hiroyams/openarm_hardware/README.md

# OpenArm Hardware



### CAD Files
All CAD files needed to build, print, and customize the OpenArm hardware platform:   
**[📁 Google Drive](https://drive.google.com/drive/folders/1a9ec9vzBV_D-AX9s_LOkBVy3ZXDC1kJT?usp=sharing)**
- **STEP** — Full assembly (leader & follower arm)
- **STL** — Ready-to-print 3D models
- **Attachments** — Camera mounts, PCB hub casing, etc.
- **Wiring** — Diagrams for cable manufacturing

### Documentation
Specifications, bill of materials (BOM), and step-by-step assembly guides:  
**[📚 docs.openarm.dev/hardware](https://docs.openarm.dev/hardware/)**  

## Contributing
We welcome contributions! Submit a pull request with:
- Custom modifications and improvements
- Assembly files for other CAD platforms (SolidWorks, OnShape, FreeCAD, etc.)
- Documentation enhancements

**Discord** — [Join our community](https://discord.gg/tpnKxHuJY3) for questions and project sharing  
**Email** — openarm@enactic.ai

## License
[CERN Open Hardware Licence Version 2 - Strongly Reciprocal](LICENSE.txt)  
Copyright 2025 Enactic, Inc.

All participation is governed by our [Code of Conduct](CODE_OF_CONDUCT.md).
