hiroyams/openarm_hardware/SolidWorks/covers/J4-J5_Cover.SLDPRT

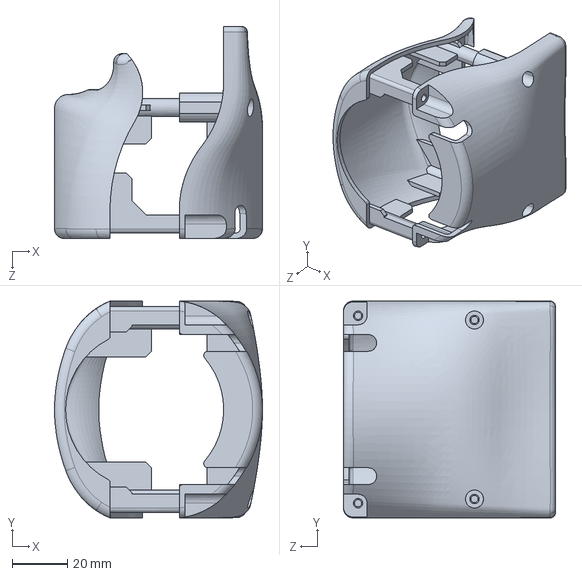
[picture p1: CAD file, 2025-08-22, last stored version]
SolidWorks/covers/J4-J5_Cover.SLDPRT
75.0 x 78.2 x 76.5 mm
