hiroyams/openarm_hardware/SolidWorks/motors/DM-J4340-2EC.SLDPRT

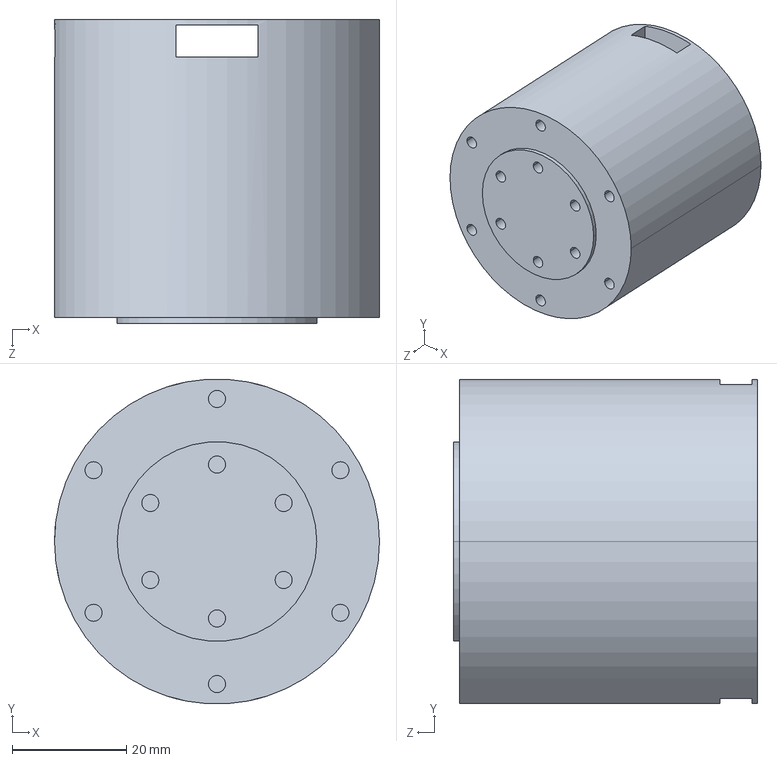
[picture p2: CAD file, 2025-08-22, last stored version]
SolidWorks/motors/DM-J4340-2EC.SLDPRT
57.0 x 56.9 x 53.3 mm
