hiroyams/openarm_hardware/SolidWorks/pedestal/pedestal_v1.0_final.STEP

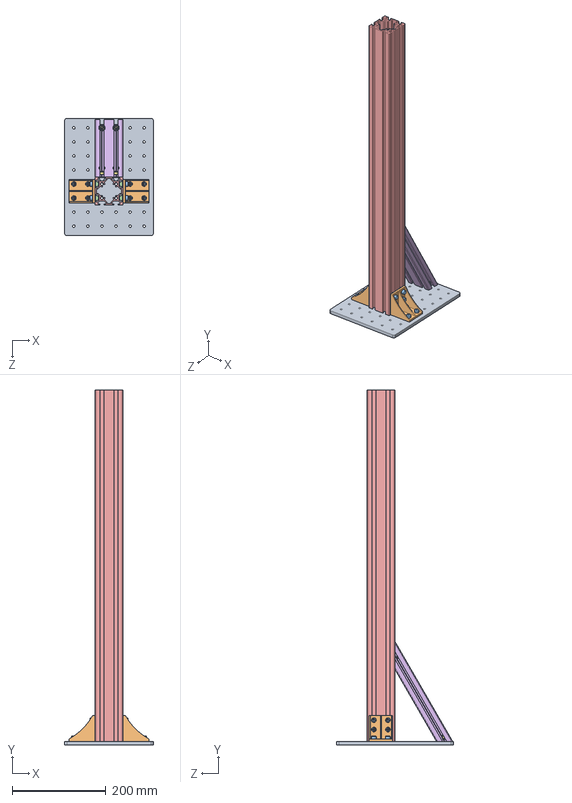
[picture p3: CAD file, 2025-08-22, last stored version]
SolidWorks/pedestal/pedestal_v1.0_final.STEP
190.0 x 758.0 x 250.0 mm
base_plate
HBLFSDW6-SEP_b x 2
CBM6-12 x 16
HNTP6-6_app x 8
Reazon_HFSB6_6060_750
HFBL30A6-3060-123-SSP_b
SCB6-12 x 4
SPWF6 x 4
SHNTP6-6 x 2
