hiroyams/openarm_hardware/SolidWorks/SLDPRT_Files/wrist_camera_mount_right.SLDPRT

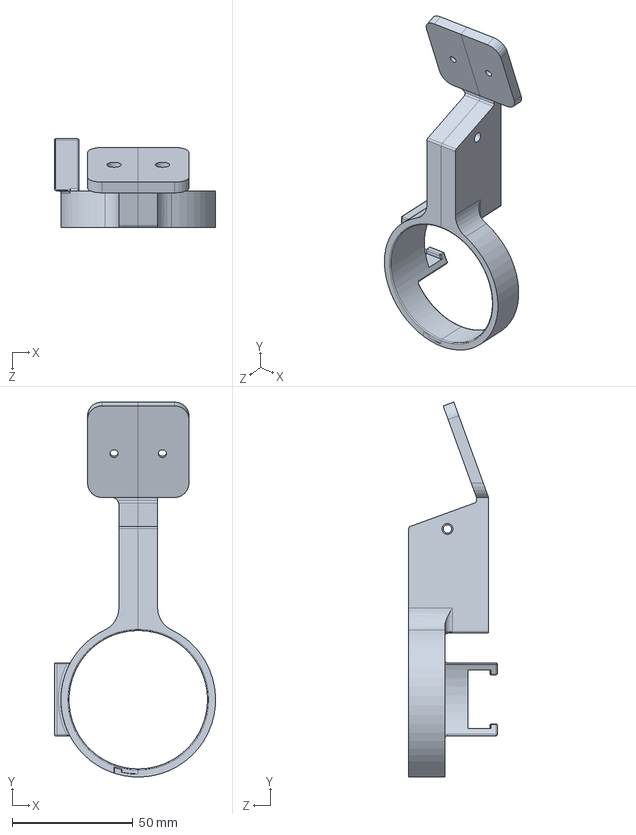
[picture p4: CAD file, 2025-09-16, last stored version]
SolidWorks/SLDPRT_Files/wrist_camera_mount_right.SLDPRT
66.6 x 155.0 x 36.6 mm
