hiroyams/openarm_hardware/SolidWorks/STEP_Files/J2_B.STEP

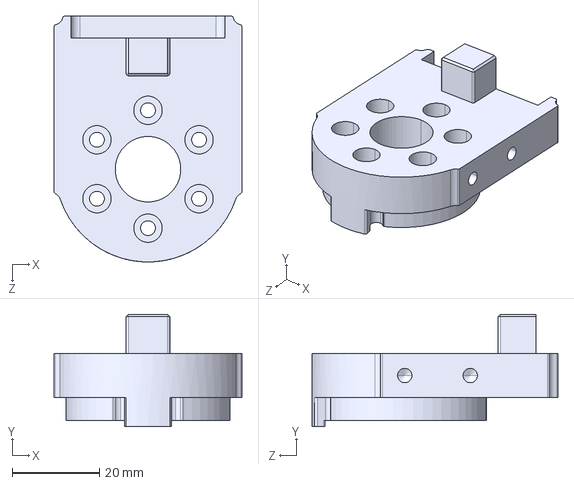
[picture p5: CAD file, 2025-08-22, last stored version]
SolidWorks/STEP_Files/J2_B.STEP
43.0 x 25.7 x 56.3 mm
