hiroyams/openarm_hardware/STL/covers/chest-b.STL

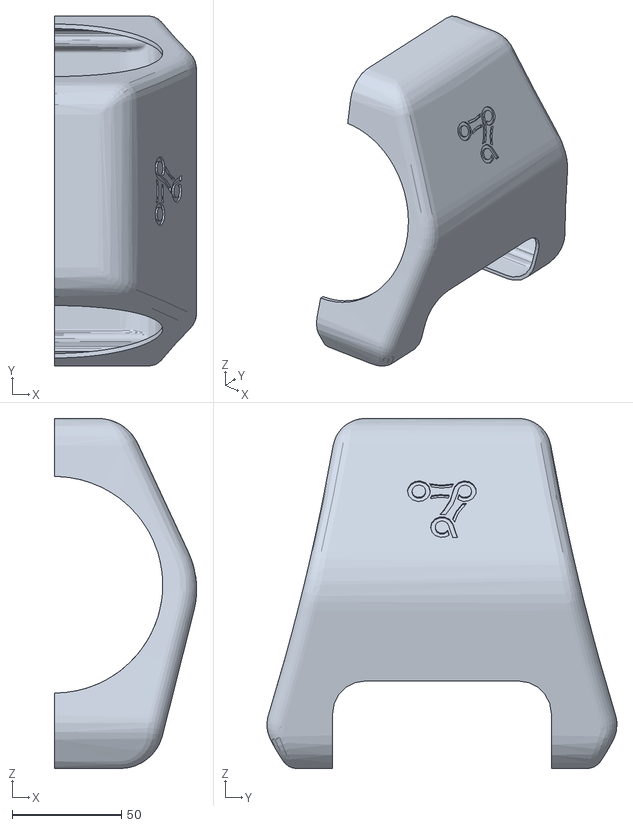
[picture p7: CAD file, 2025-07-17, last stored version]
STL/covers/chest-b.STL
65.0 x 160.0 x 160.0
