hiroyams/openarm_hardware/STL/covers/left/left_covers.3mf

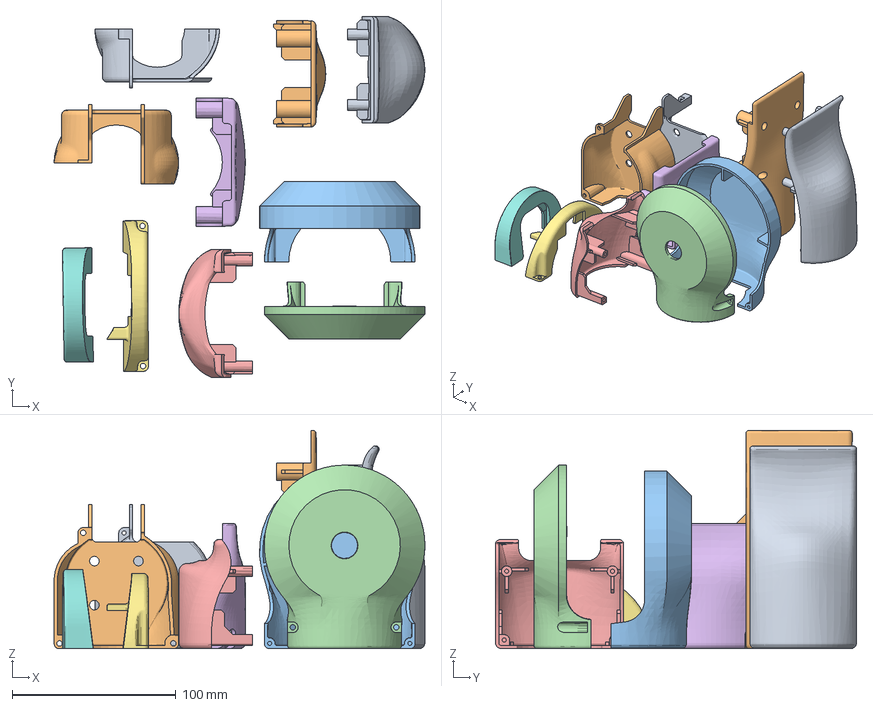
[picture p8: CAD file, 2025-08-27, last stored version]
STL/covers/left/left_covers.3mf
226.2 x 220.2 x 133.2 mm
j3-a-right.STL
j3-b-right.stl
j1-b-right.STL
j2-b-right.STL
j4-a-right.STL
j4-b-right.STL
j1-a-right.STL
j2-a-right.STL
j6-a-left.STL
j6-b-left.STL
