hiroyams/openarm_hardware/STL/follower/left-jaw.STL

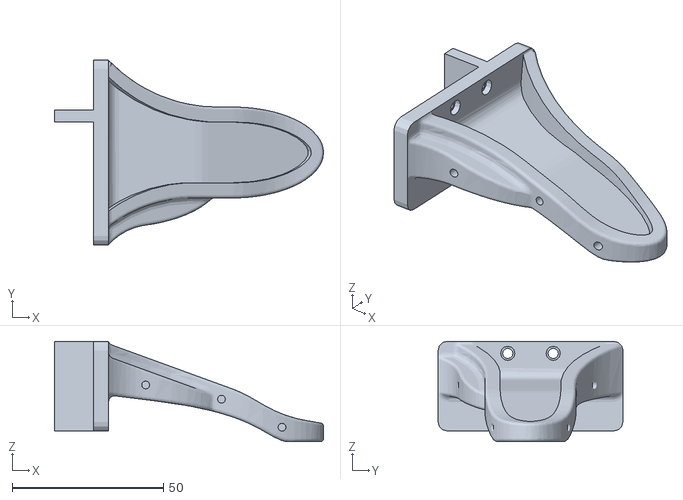
[picture p9: CAD file, 2025-07-17, last stored version]
STL/follower/left-jaw.STL
88.8 x 61.0 x 33.2
