hiroyams/openarm_hardware/STL/leader/swivel-rotor-leader.STL

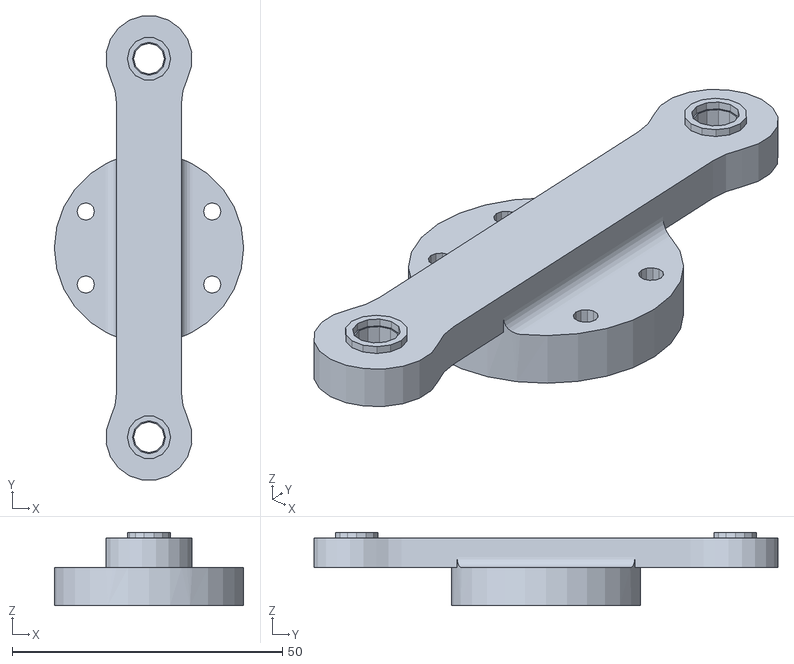
[picture p10: CAD file, 2025-07-17, last stored version]
STL/leader/swivel-rotor-leader.STL
35.0 x 85.8 x 13.5
