hiroyams/openarm_hardware/SolidWorks/covers/J1-J2_Cover.SLDPRT

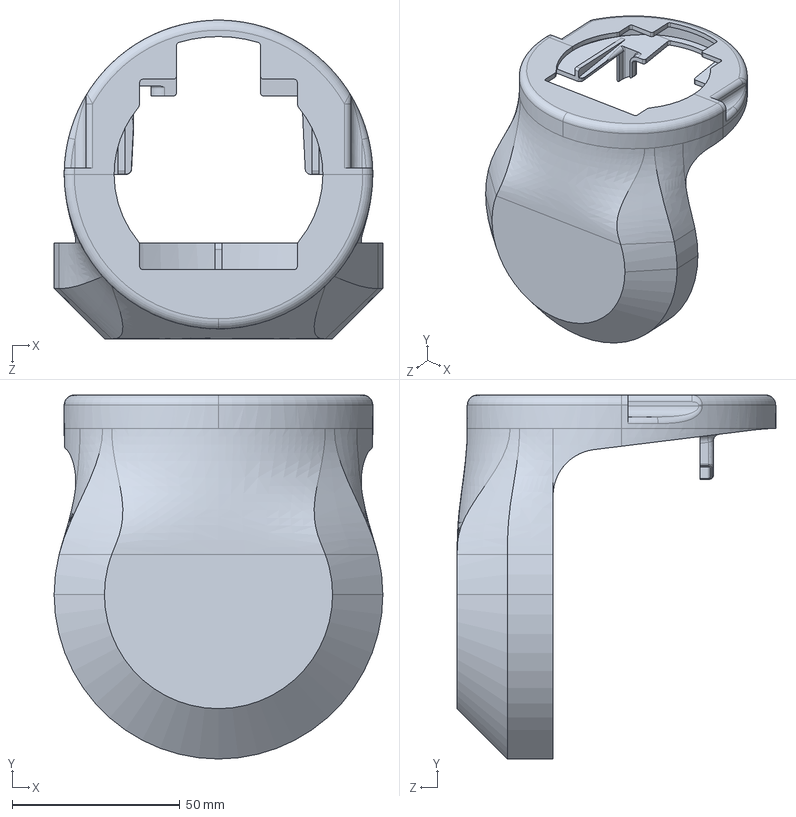
[picture p11: CAD file, 2025-08-22, last stored version]
SolidWorks/covers/J1-J2_Cover.SLDPRT
98.0 x 108.5 x 95.0 mm
