hiroyams/openarm_hardware/SolidWorks/motors/DM-J8009P-2EC.SLDPRT

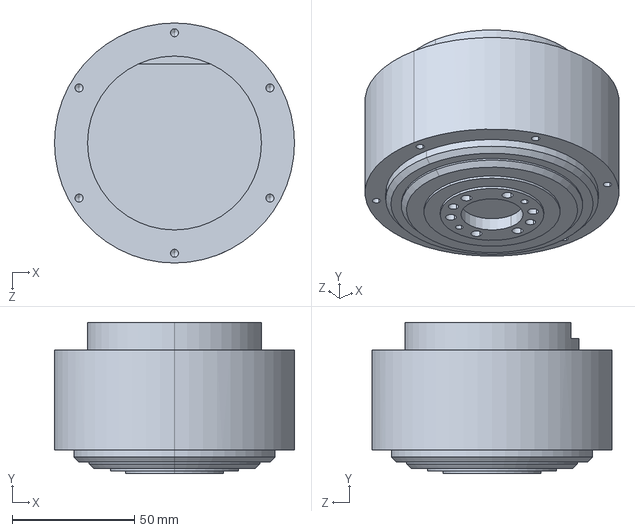
[picture p12: CAD file, 2025-08-22, last stored version]
SolidWorks/motors/DM-J8009P-2EC.SLDPRT
98.0 x 61.7 x 98.0 mm
