hiroyams/openarm_hardware/SolidWorks/STEP_Files/J7_D_right.STEP

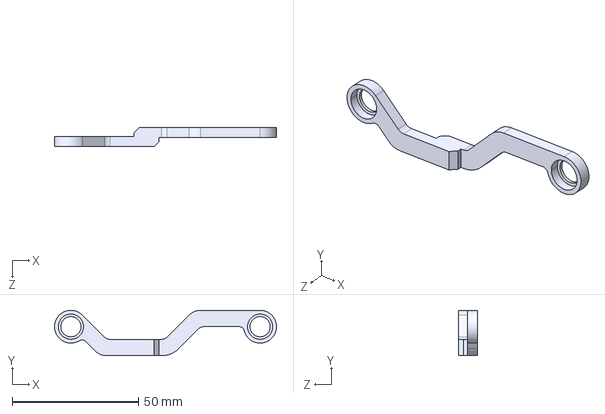
[picture p13: CAD file, 2025-08-22, last stored version]
SolidWorks/STEP_Files/J7_D_right.STEP
88.0 x 18.0 x 7.50 mm
