hiroyams/openarm_hardware/STL/covers/chest-a.STL

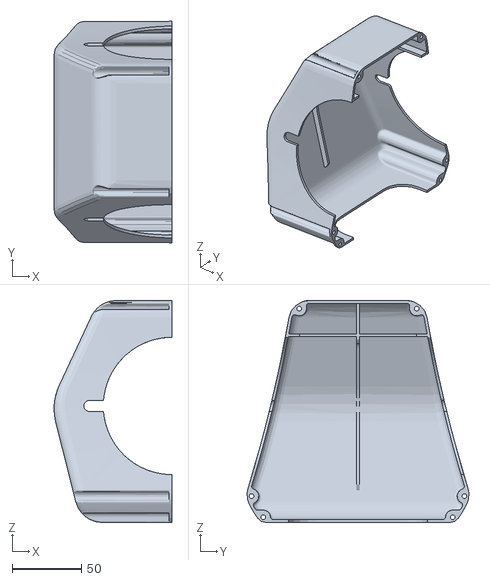
[picture p14: CAD file, 2025-07-17, last stored version]
STL/covers/chest-a.STL
85.0 x 160.0 x 160.0
