hiroyams/openarm_hardware/STL/covers/left/j6-b-left.STL

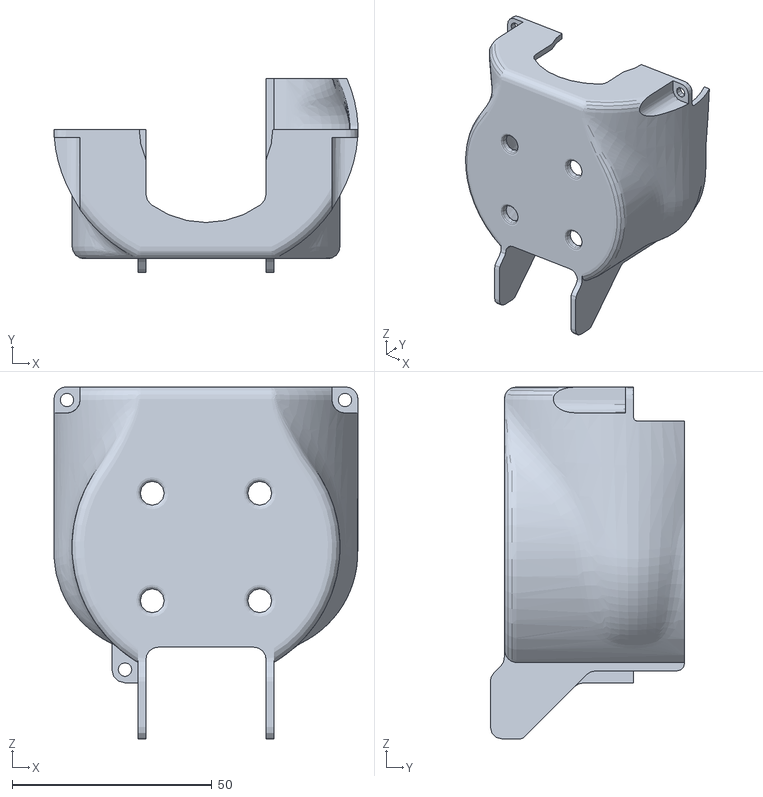
[picture p15: CAD file, 2025-07-22, last stored version]
STL/covers/left/j6-b-left.STL
76.0 x 48.6 x 88.0
