hiroyams/openarm_hardware/STL/covers/right/j2-b-right.STL

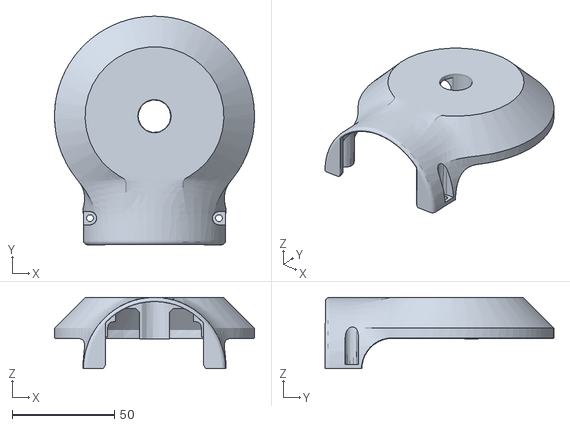
[picture p16: CAD file, 2025-07-22, last stored version]
STL/covers/right/j2-b-right.STL
98.0 x 112.0 x 34.8
