hiroyams/openarm_hardware/STL/leader/ee-linkage.STL

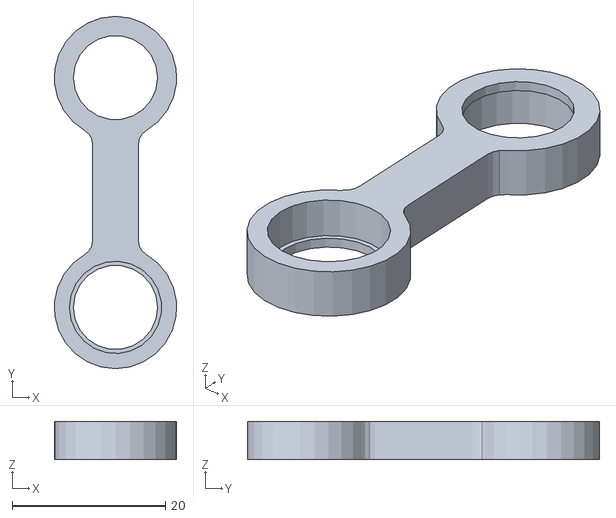
[picture p17: CAD file, 2025-07-17, last stored version]
STL/leader/ee-linkage.STL
15.9 x 46.0 x 5.00
