hiroyams/openarm_hardware/SolidWorks/covers/J6-J7_Cover_Left.SLDPRT

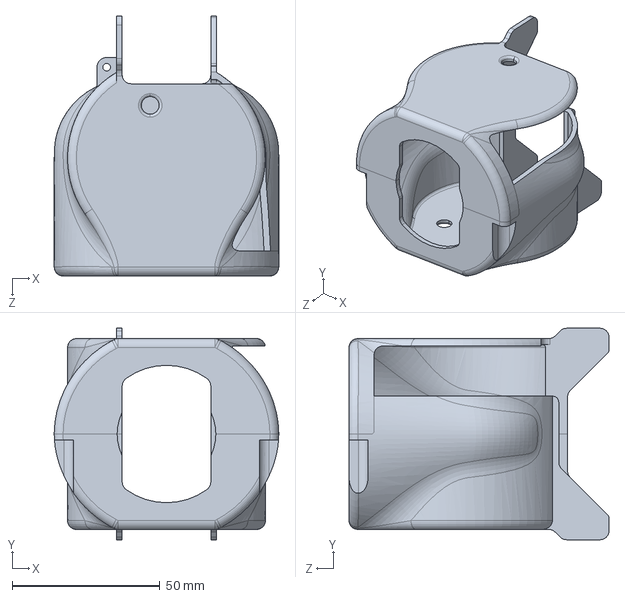
[picture p18: CAD file, 2025-08-22, last stored version]
SolidWorks/covers/J6-J7_Cover_Left.SLDPRT
76.0 x 71.6 x 88.0 mm
