hiroyams/openarm_hardware/SolidWorks/motors/DM-J4310-2EC.SLDPRT

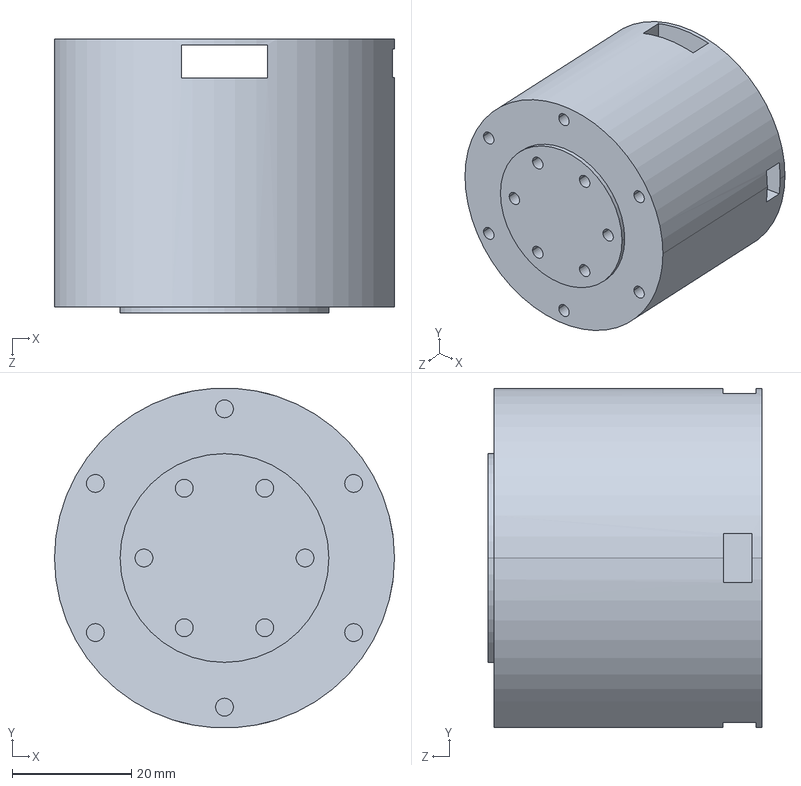
[picture p19: CAD file, 2025-08-22, last stored version]
SolidWorks/motors/DM-J4310-2EC.SLDPRT
57.0 x 56.9 x 46.0 mm
