hiroyams/openarm_hardware/SolidWorks/STEP_Files/J7_E.STEP

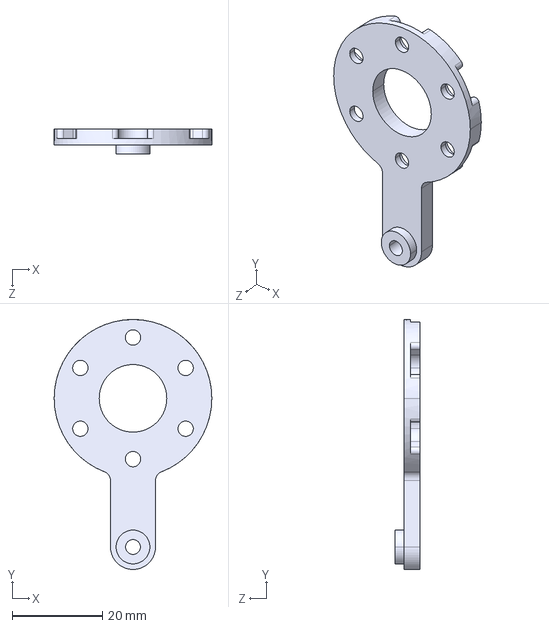
[picture p20: CAD file, 2025-08-22, last stored version]
SolidWorks/STEP_Files/J7_E.STEP
35.0 x 55.5 x 5.60 mm
