hiroyams/openarm_hardware/STL/covers/right/j6-a-right.STL

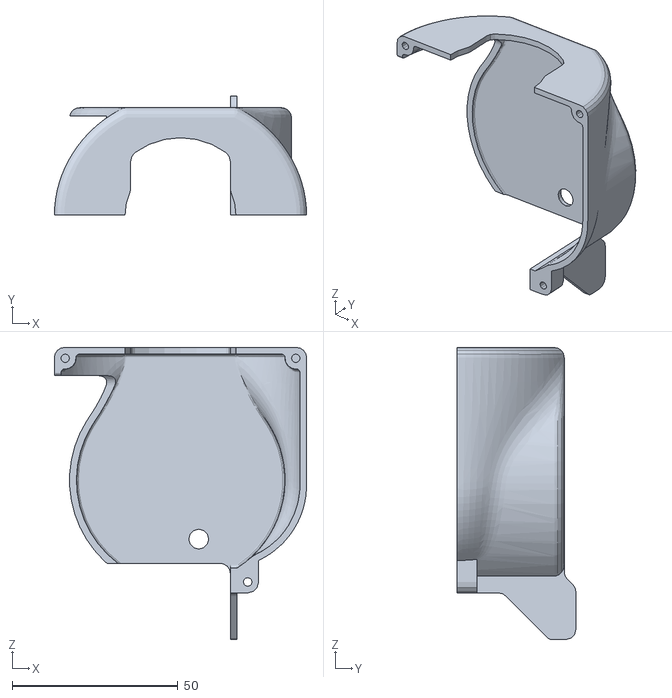
[picture p21: CAD file, 2025-07-22, last stored version]
STL/covers/right/j6-a-right.STL
76.0 x 35.8 x 88.0
