hiroyams/openarm_hardware/STL/leader/right-pincer.STL

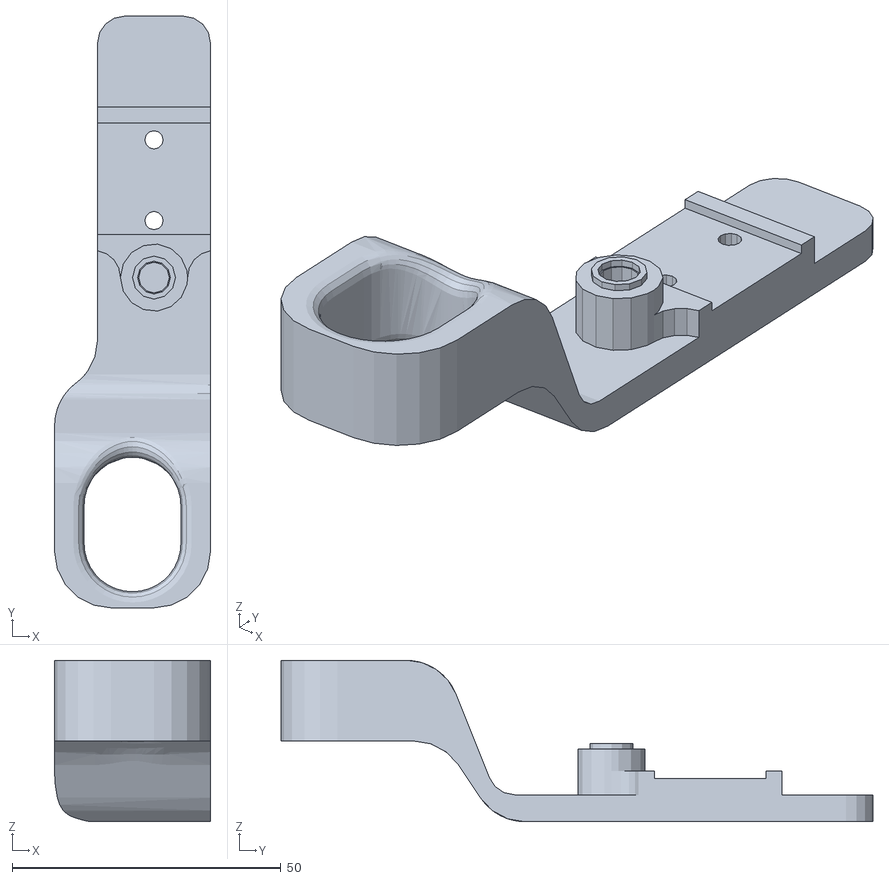
[picture p22: CAD file, 2025-07-17, last stored version]
STL/leader/right-pincer.STL
29.0 x 110.0 x 30.0
