hiroyams/openarm_hardware/SolidWorks/covers/J3-J4_Cover.SLDPRT

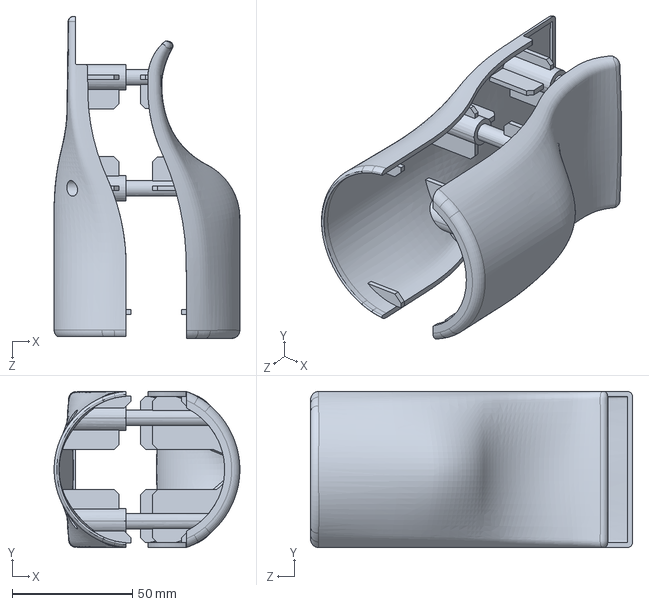
[picture p23: CAD file, 2025-08-22, last stored version]
SolidWorks/covers/J3-J4_Cover.SLDPRT
77.3 x 65.0 x 134.0 mm
