hiroyams/openarm_hardware/SolidWorks/motors/DM-J4340P-2EC.SLDPRT

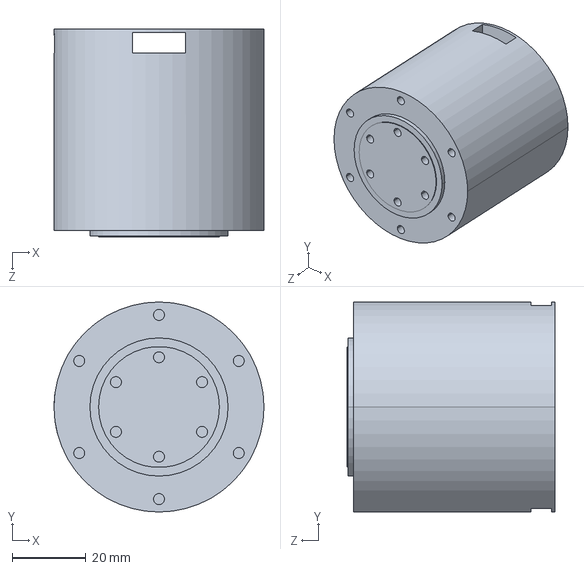
[picture p24: CAD file, 2025-08-22, last stored version]
SolidWorks/motors/DM-J4340P-2EC.SLDPRT
57.0 x 57.0 x 56.5 mm
