hiroyams/openarm_hardware/SolidWorks/STEP_Files/rail_CNC_attachment.STEP

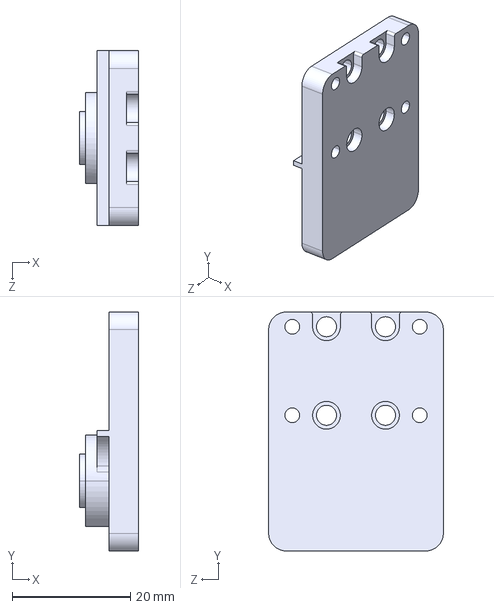
[picture p25: CAD file, 2025-08-22, last stored version]
SolidWorks/STEP_Files/rail_CNC_attachment.STEP
10.0 x 40.5 x 29.6 mm
