hiroyams/openarm_hardware/STL/covers/right/j1-a-right.STL

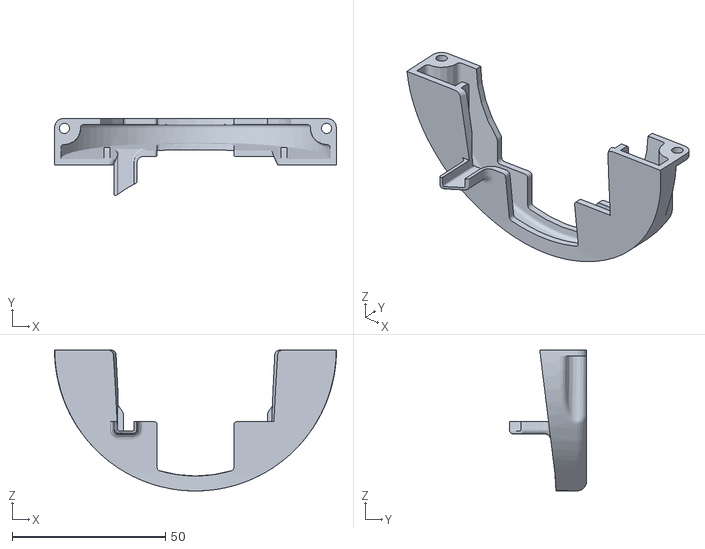
[picture p26: CAD file, 2025-07-22, last stored version]
STL/covers/right/j1-a-right.STL
92.0 x 25.2 x 46.0
