hiroyams/openarm_hardware/SolidWorks/covers/J2-J3_Cover.SLDPRT

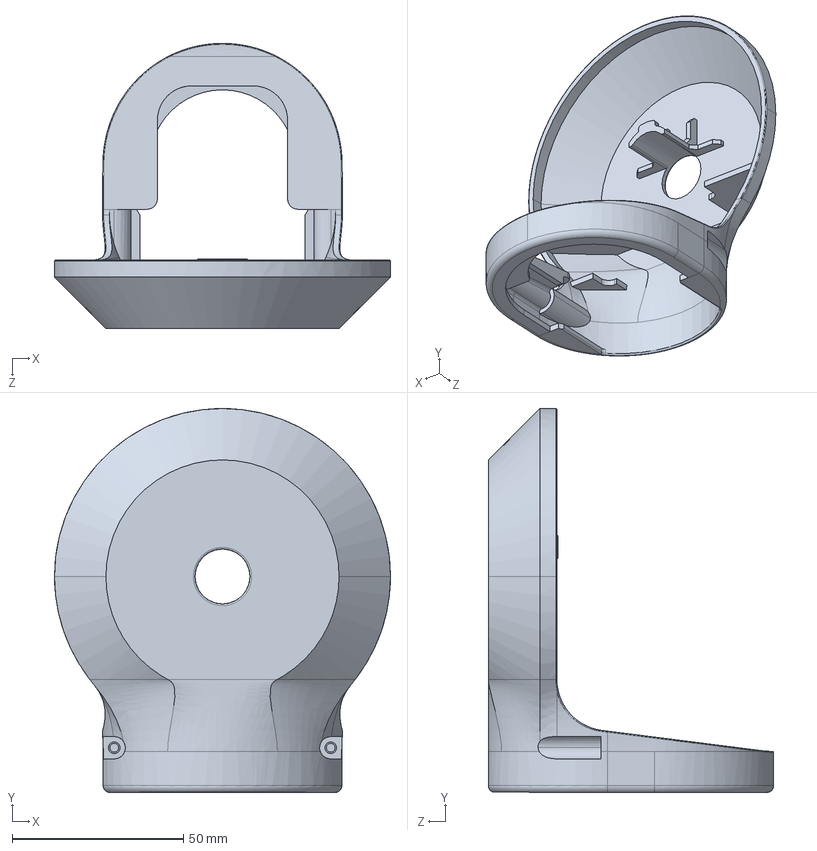
[picture p27: CAD file, 2025-08-22, last stored version]
SolidWorks/covers/J2-J3_Cover.SLDPRT
98.0 x 112.0 x 83.2 mm
