hiroyams/openarm_hardware/SolidWorks/STEP_Files/J7_C.STEP

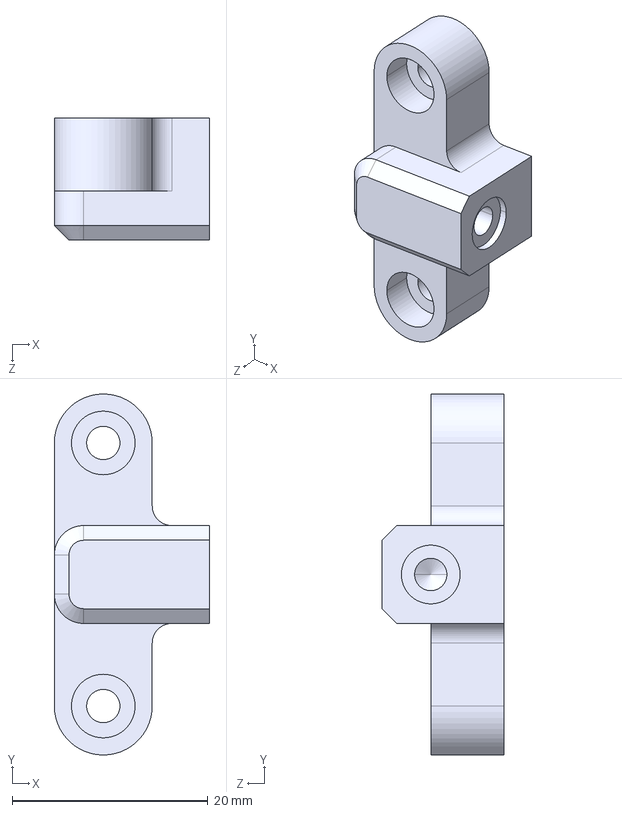
[picture p28: CAD file, 2025-08-22, last stored version]
SolidWorks/STEP_Files/J7_C.STEP
15.9 x 36.9 x 12.5 mm
