hiroyams/openarm_hardware/STL/covers/left/j1-b-left.STL

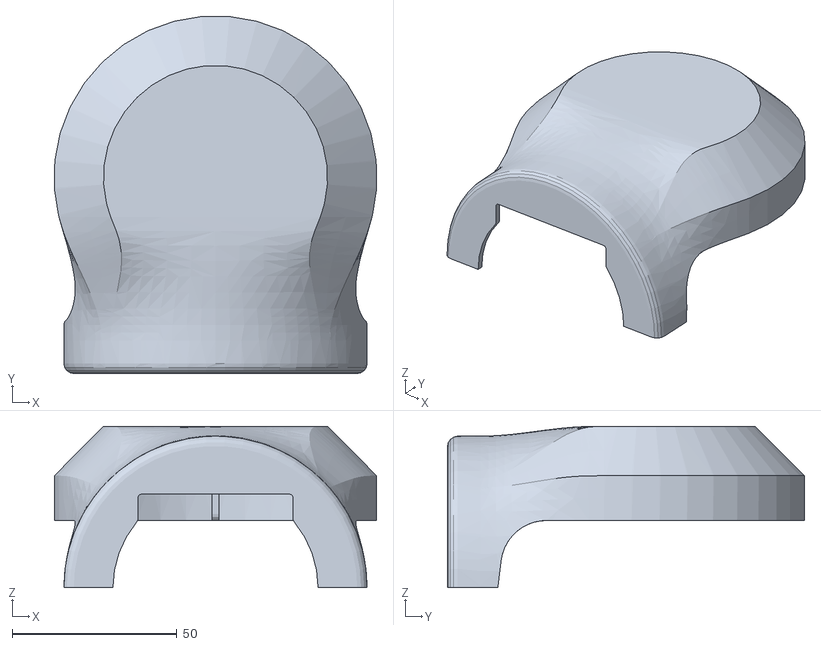
[picture p29: CAD file, 2025-07-22, last stored version]
STL/covers/left/j1-b-left.STL
97.8 x 108.3 x 49.0
