hiroyams/openarm_hardware/SolidWorks/STEP_Files/J4_B.STEP

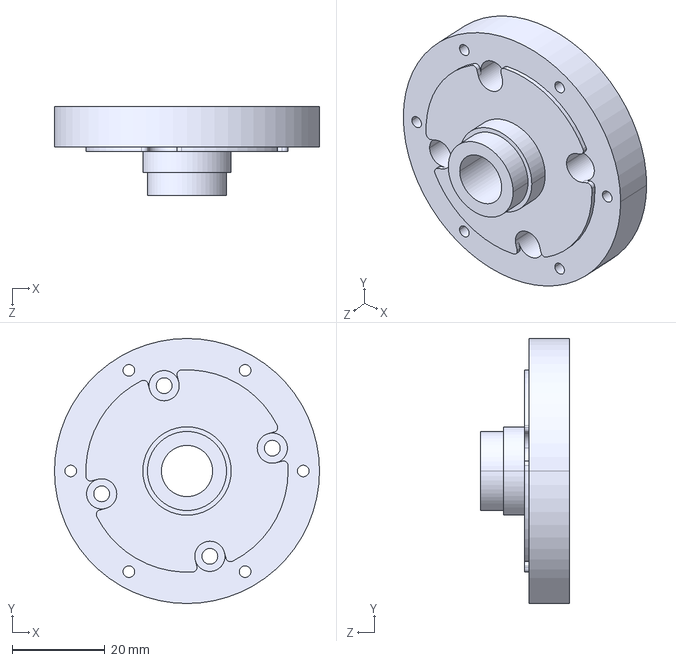
[picture p30: CAD file, 2025-08-22, last stored version]
SolidWorks/STEP_Files/J4_B.STEP
57.0 x 57.0 x 19.2 mm
