hiroyams/openarm_hardware/STL/leader/rail-connector-leader.STL

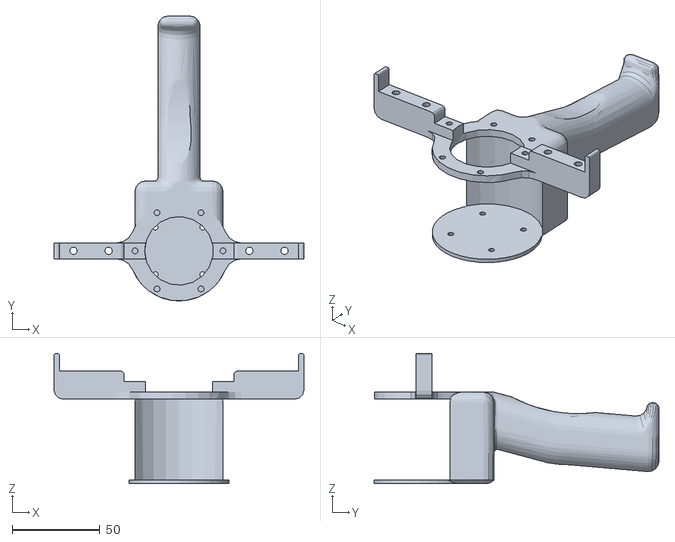
[picture p31: CAD file, 2025-07-17, last stored version]
STL/leader/rail-connector-leader.STL
142.0 x 162.0 x 74.0
