hiroyams/openarm_hardware/SolidWorks/covers/Chest_Cover.SLDPRT

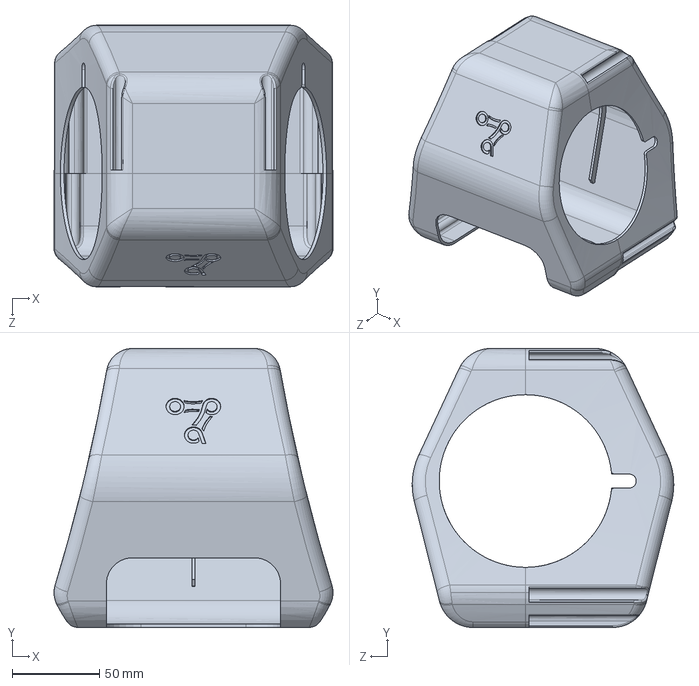
[picture p32: CAD file, 2025-08-22, last stored version]
SolidWorks/covers/Chest_Cover.SLDPRT
160.0 x 160.0 x 150.0 mm
