hiroyams/openarm_hardware/SolidWorks/STEP_Files/J6_C_left.STEP

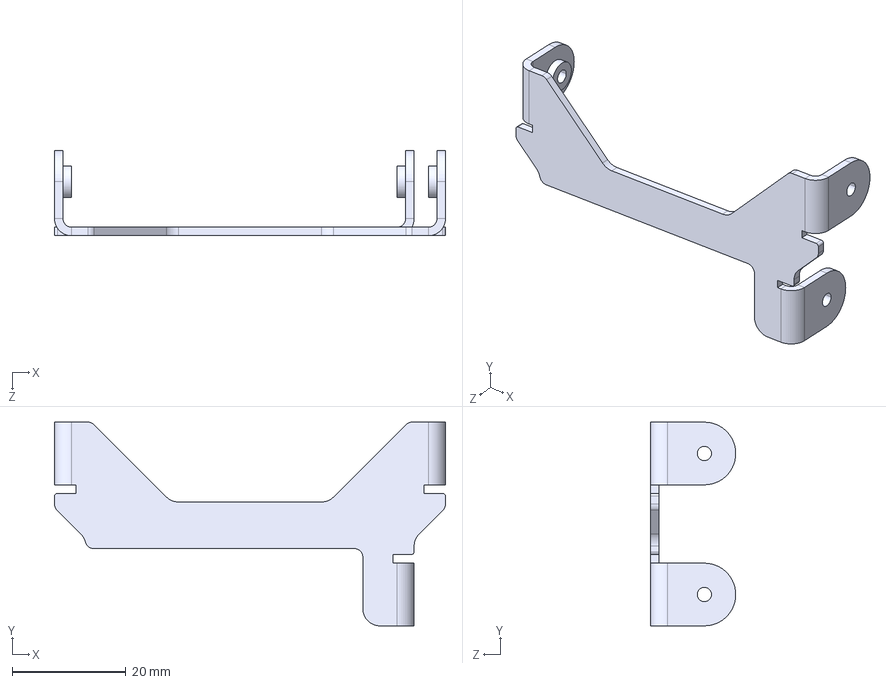
[picture p33: CAD file, 2025-08-22, last stored version]
SolidWorks/STEP_Files/J6_C_left.STEP
68.6 x 35.7 x 15.0 mm
