hiroyams/openarm_hardware/STL/covers/left/j2-a-left.STL

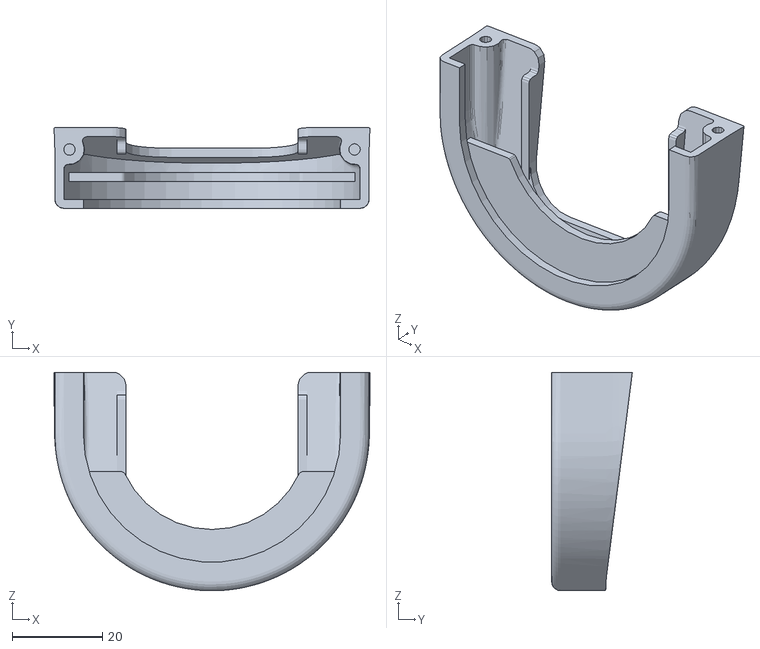
[picture p34: CAD file, 2025-07-22, last stored version]
STL/covers/left/j2-a-left.STL
70.0 x 17.9 x 48.4
