hiroyams/openarm_hardware/SolidWorks/STEP_Files/rail-connector-leader.STEP

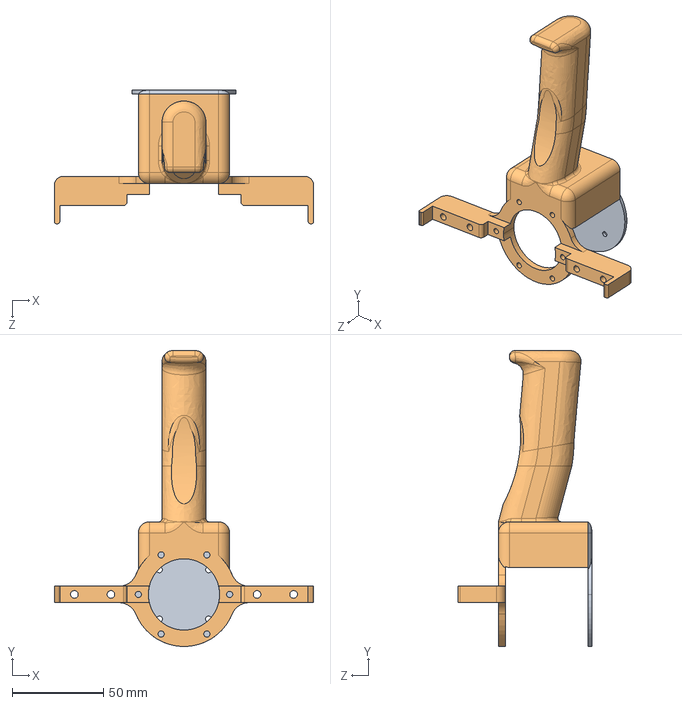
[picture p35: CAD file, 2025-08-22, last stored version]
SolidWorks/STEP_Files/rail-connector-leader.STEP
142.0 x 162.0 x 73.1 mm
