hiroyams/openarm_hardware/STL/covers/left/j3-b-left.stl

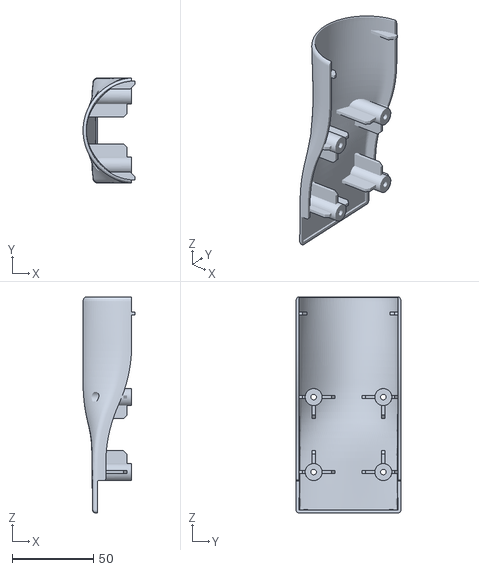
[picture p36: CAD file, 2025-07-17, last stored version]
STL/covers/left/j3-b-left.stl
32.0 x 65.0 x 133.2
