hiroyams/openarm_hardware/SolidWorks/STEP_Files/J4_D.STEP

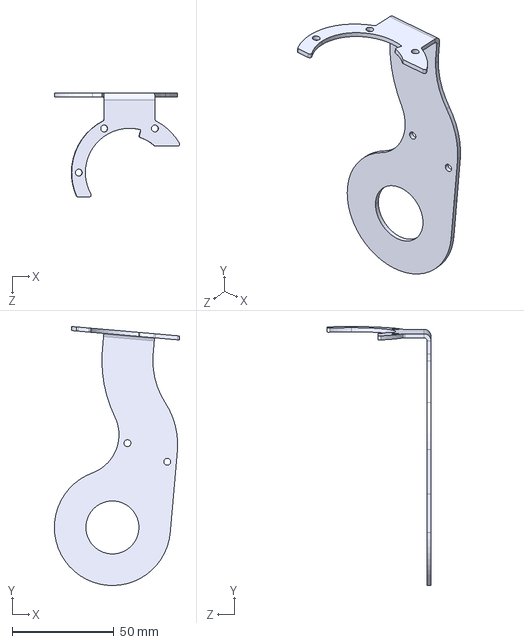
[picture p37: CAD file, 2025-08-22, last stored version]
SolidWorks/STEP_Files/J4_D.STEP
61.5 x 127.1 x 51.1 mm
