hiroyams/openarm_hardware/STL/covers/left/j4-a-left.STL

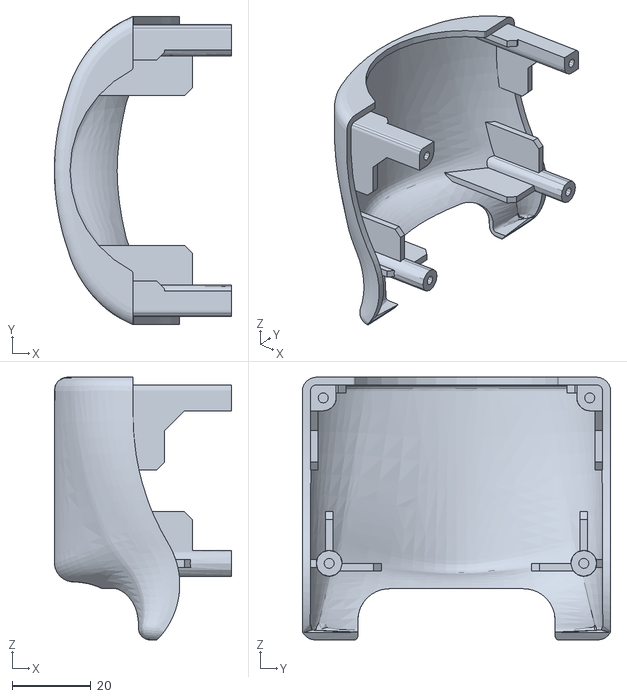
[picture p38: CAD file, 2025-07-17, last stored version]
STL/covers/left/j4-a-left.STL
45.0 x 78.2 x 66.7
