hiroyams/openarm_hardware/STL/covers/right/j3-a-right.STL

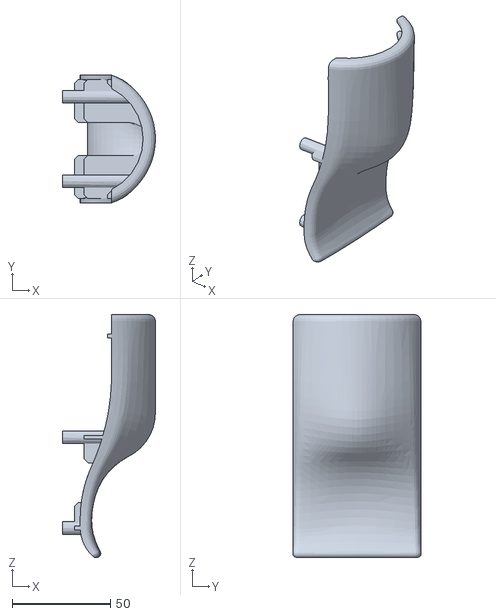
[picture p39: CAD file, 2025-07-17, last stored version]
STL/covers/right/j3-a-right.STL
47.3 x 65.0 x 123.7
