hiroyams/openarm_hardware/SolidWorks/STEP_Files/J7_A.STEP

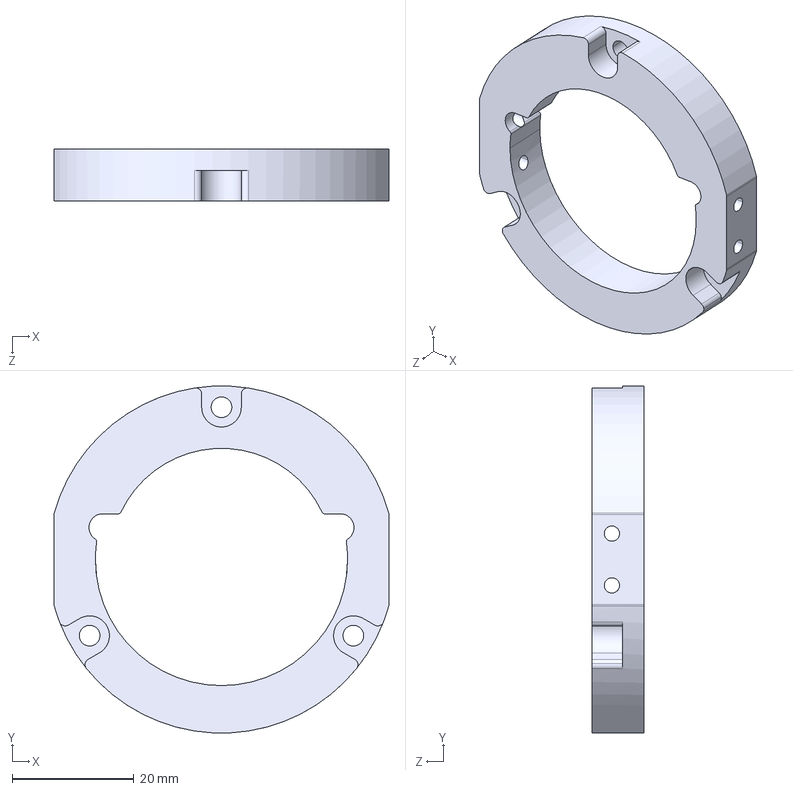
[picture p40: CAD file, 2025-08-22, last stored version]
SolidWorks/STEP_Files/J7_A.STEP
55.0 x 56.9 x 8.50 mm
