hiroyams/openarm_hardware/SolidWorks/STEP_Files/J8_B.STEP

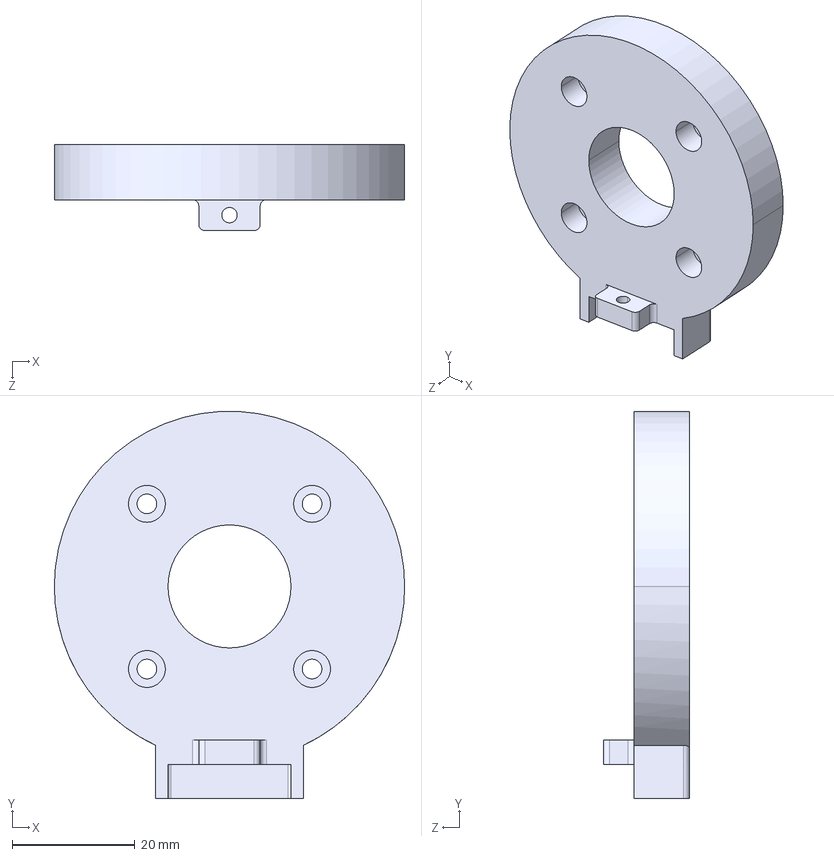
[picture p41: CAD file, 2025-08-22, last stored version]
SolidWorks/STEP_Files/J8_B.STEP
57.0 x 63.0 x 14.0 mm
