hiroyams/openarm_hardware/STL/covers/left/j4-b-left.STL

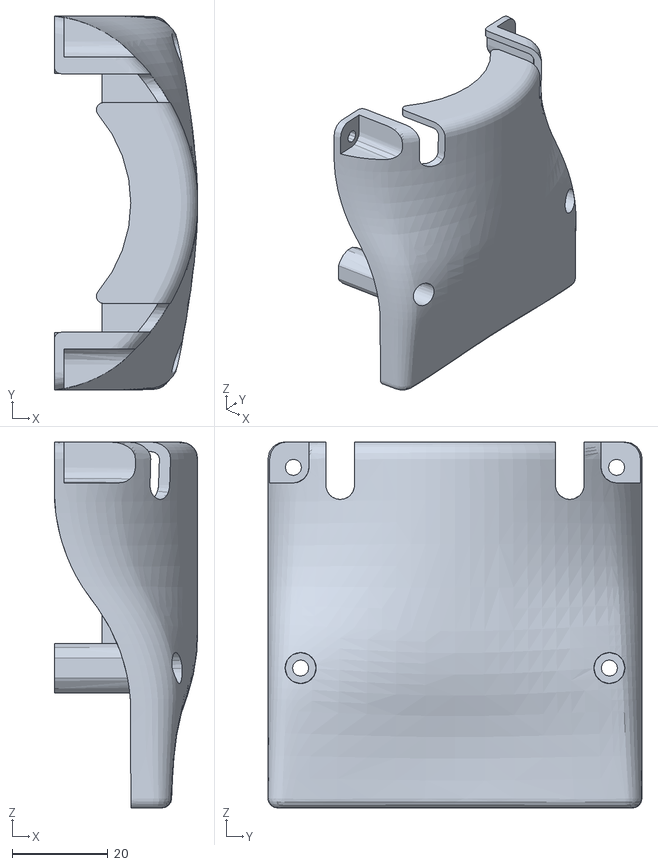
[picture p42: CAD file, 2025-07-17, last stored version]
STL/covers/left/j4-b-left.STL
30.0 x 78.2 x 76.5
