hiroyams/openarm_hardware/SolidWorks/STEP_Files/J8_A.STEP

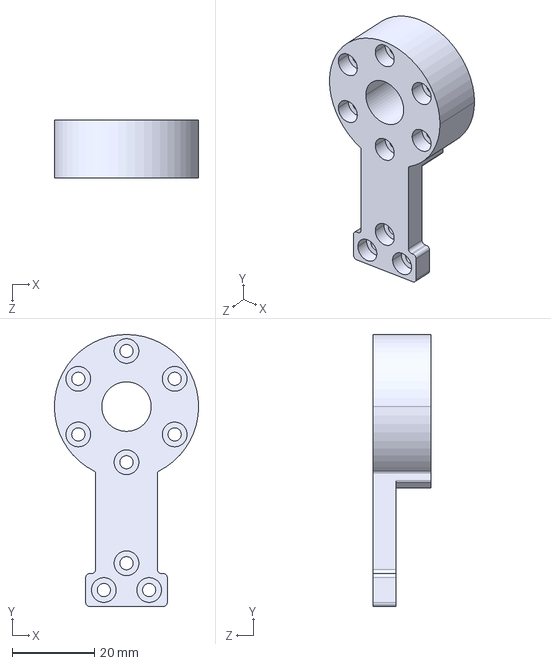
[picture p43: CAD file, 2025-08-22, last stored version]
SolidWorks/STEP_Files/J8_A.STEP
35.0 x 66.0 x 14.0 mm
