hiroyams/openarm_hardware/SolidWorks/STEP_Files/J1_C.STEP

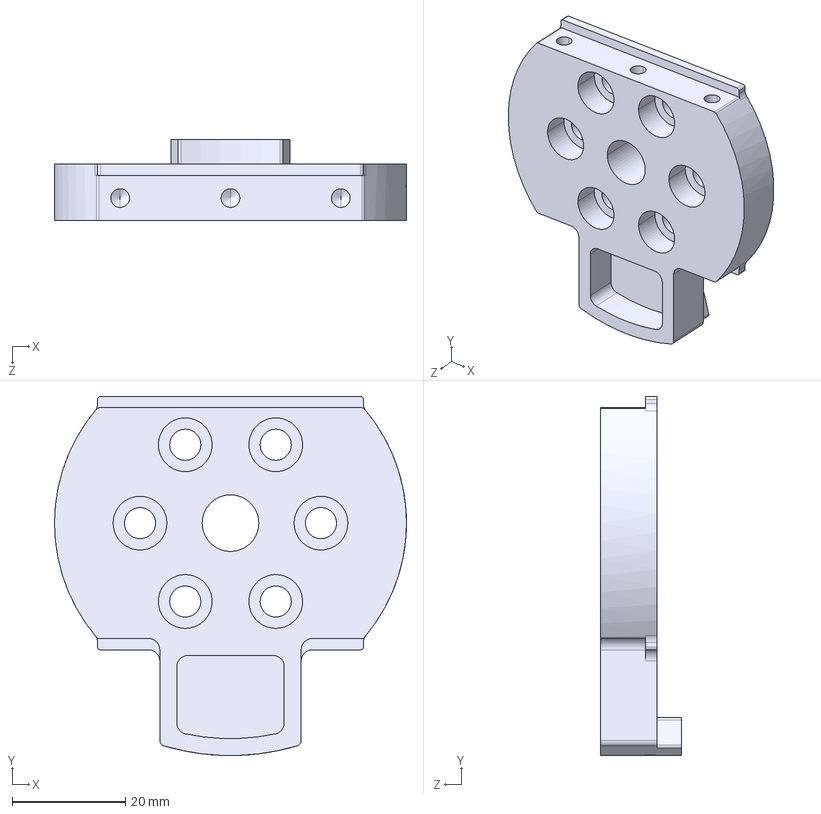
[picture p44: CAD file, 2025-08-22, last stored version]
SolidWorks/STEP_Files/J1_C.STEP
62.2 x 63.5 x 14.4 mm
