hiroyams/openarm_hardware/SolidWorks/STEP_Files/J4_E.STEP

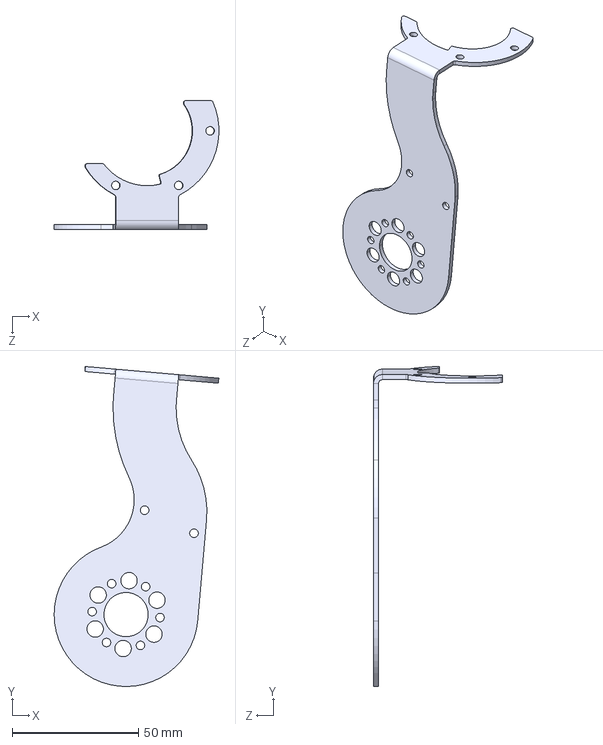
[picture p45: CAD file, 2025-08-22, last stored version]
SolidWorks/STEP_Files/J4_E.STEP
65.3 x 126.8 x 51.1 mm
