hiroyams/openarm_hardware/SolidWorks/STEP_Files/rail_connector.STEP

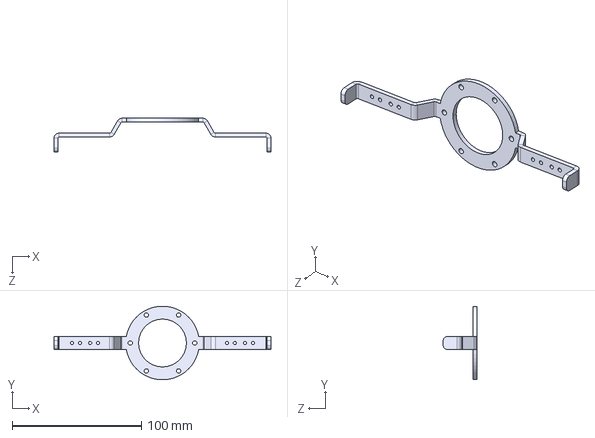
[picture p46: CAD file, 2025-08-22, last stored version]
SolidWorks/STEP_Files/rail_connector.STEP
168.1 x 56.9 x 26.0 mm
