hiroyams/openarm_hardware/SolidWorks/STEP_Files/J6_D.STEP

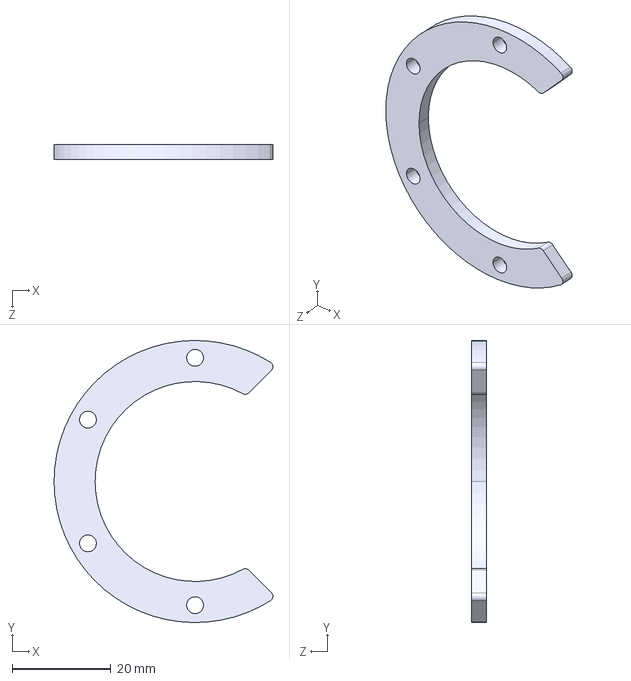
[picture p47: CAD file, 2025-08-22, last stored version]
SolidWorks/STEP_Files/J6_D.STEP
44.2 x 57.0 x 3.00 mm
