hiroyams/openarm_hardware/SolidWorks/STEP_Files/J2_C.STEP

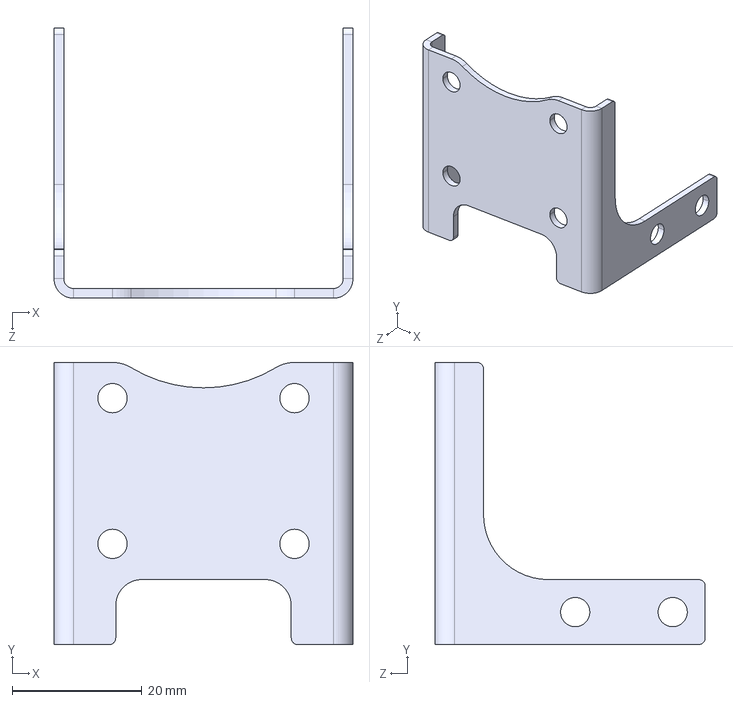
[picture p48: CAD file, 2025-08-22, last stored version]
SolidWorks/STEP_Files/J2_C.STEP
46.0 x 43.4 x 41.6 mm
