hiroyams/openarm_hardware/SolidWorks/STEP_Files/J1_D.STEP

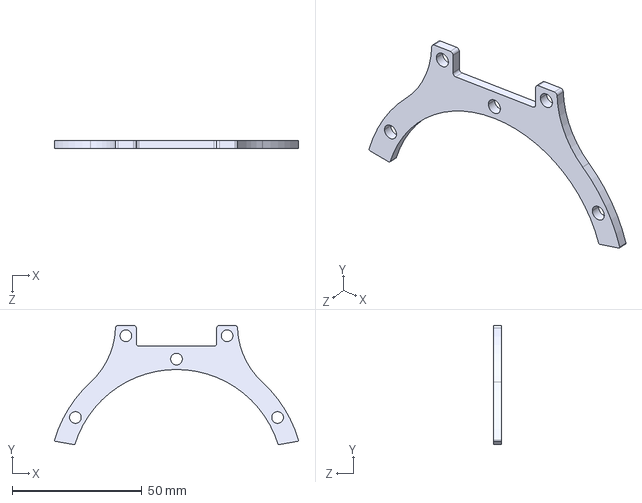
[picture p49: CAD file, 2025-08-22, last stored version]
SolidWorks/STEP_Files/J1_D.STEP
94.1 x 46.0 x 3.00 mm
