hiroyams/openarm_hardware/SolidWorks/STEP_Files/J4_A.STEP

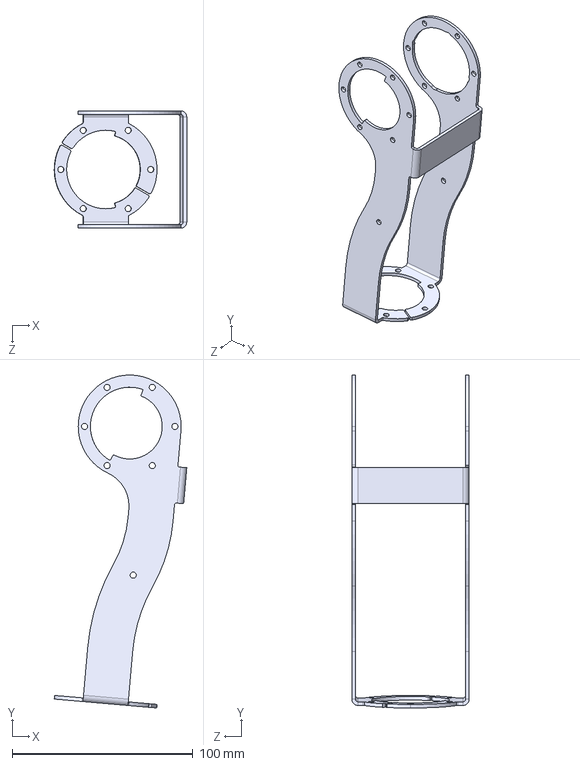
[picture p50: CAD file, 2025-08-22, last stored version]
SolidWorks/STEP_Files/J4_A.STEP
73.4 x 184.4 x 65.0 mm
