hiroyams/openarm_hardware/SolidWorks/STEP_Files/J1_B.STEP

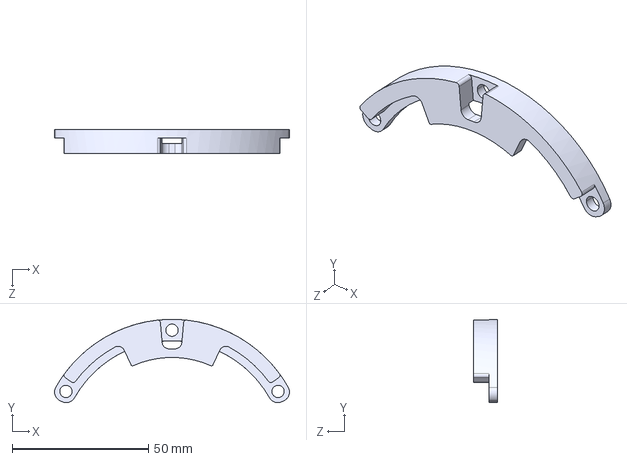
[picture p51: CAD file, 2025-08-22, last stored version]
SolidWorks/STEP_Files/J1_B.STEP
86.3 x 30.6 x 8.70 mm
