hiroyams/openarm_hardware/SolidWorks/STEP_Files/J4_C.STEP

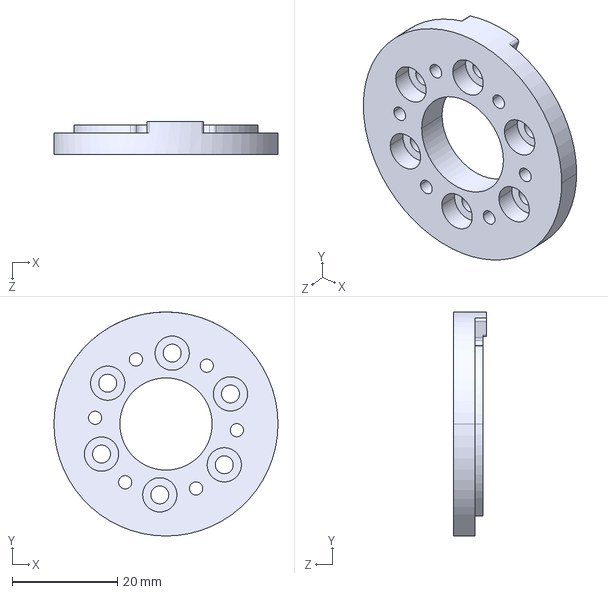
[picture p52: CAD file, 2025-08-22, last stored version]
SolidWorks/STEP_Files/J4_C.STEP
42.5 x 42.5 x 6.30 mm
