hiroyams/openarm_hardware/SolidWorks/STEP_Files/swivel_link.STEP

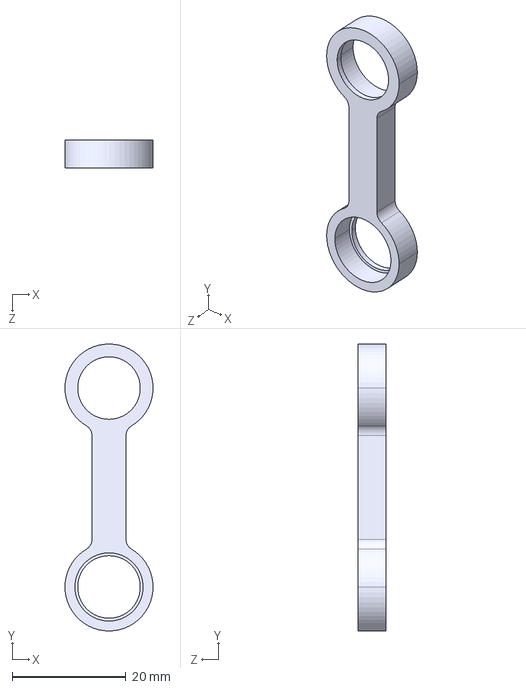
[picture p53: CAD file, 2025-08-22, last stored version]
SolidWorks/STEP_Files/swivel_link.STEP
15.5 x 50.5 x 5.00 mm
