hiroyams/openarm_hardware/SolidWorks/STEP_Files/J5_A.STEP

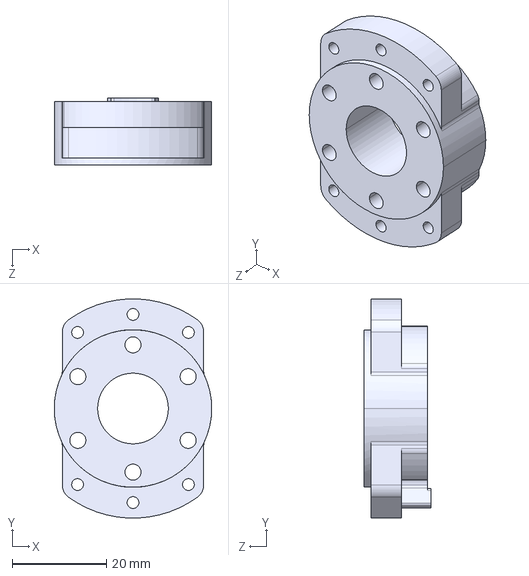
[picture p54: CAD file, 2025-08-22, last stored version]
SolidWorks/STEP_Files/J5_A.STEP
33.4 x 46.4 x 14.2 mm
