hiroyams/openarm_hardware/SolidWorks/STEP_Files/swivel_rotor.STEP

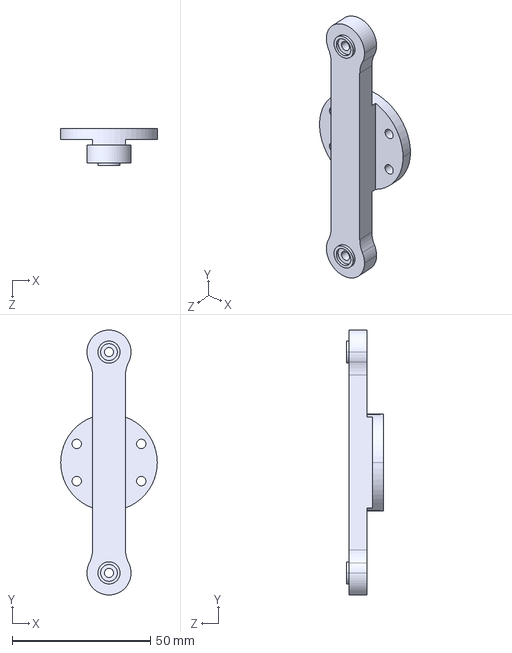
[picture p55: CAD file, 2025-08-22, last stored version]
SolidWorks/STEP_Files/swivel_rotor.STEP
35.0 x 96.0 x 13.5 mm
