hiroyams/openarm_hardware/SolidWorks/STEP_Files/J1_A.STEP

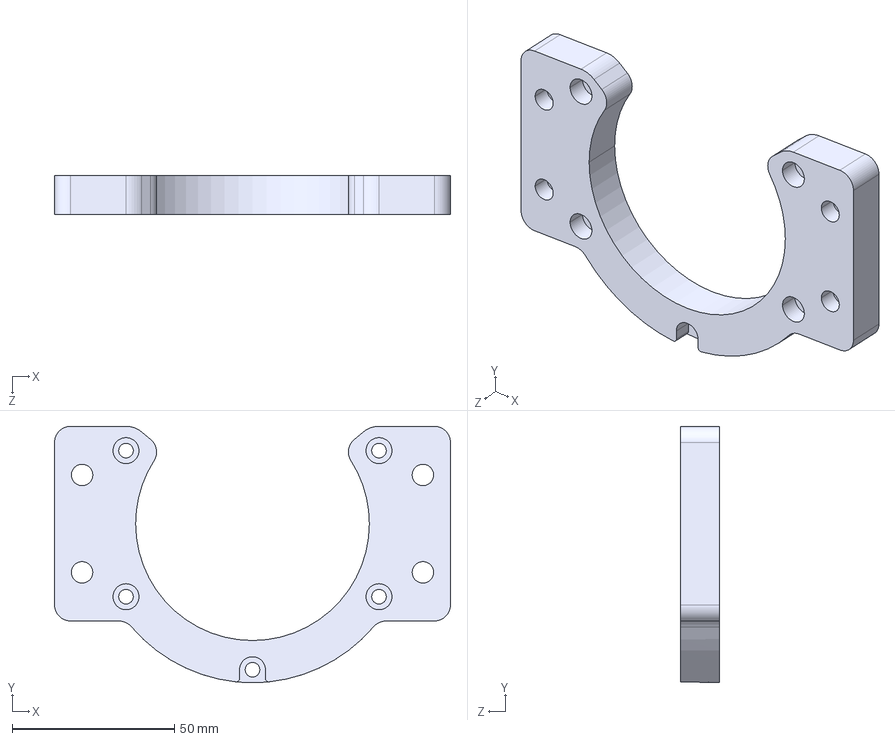
[picture p56: CAD file, 2025-08-22, last stored version]
SolidWorks/STEP_Files/J1_A.STEP
122.0 x 79.0 x 12.0 mm
