hiroyams/openarm_hardware/SolidWorks/STEP_Files/J7_B.STEP

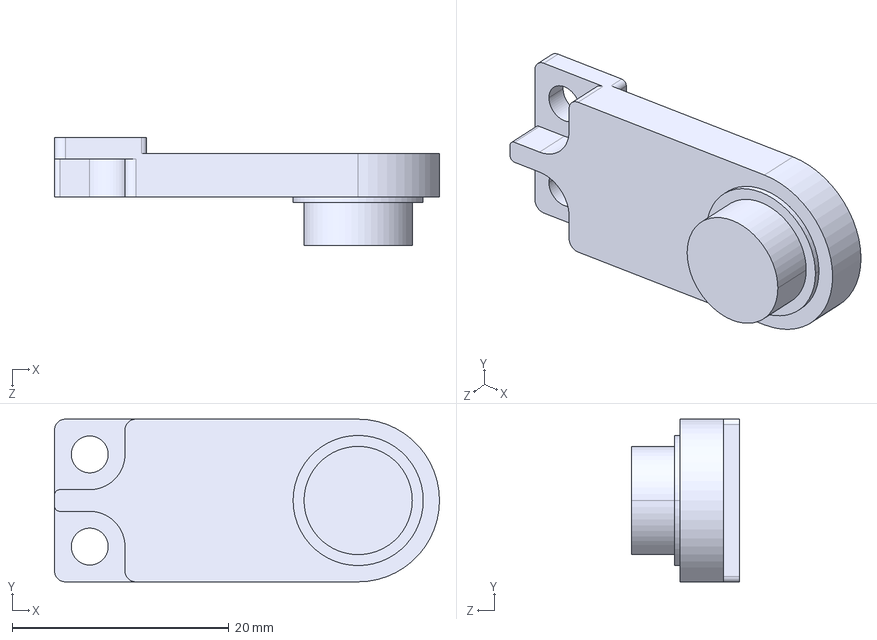
[picture p57: CAD file, 2025-08-22, last stored version]
SolidWorks/STEP_Files/J7_B.STEP
35.5 x 15.0 x 10.0 mm
