hiroyams/openarm_hardware/SolidWorks/STEP_Files/J1_E.STEP

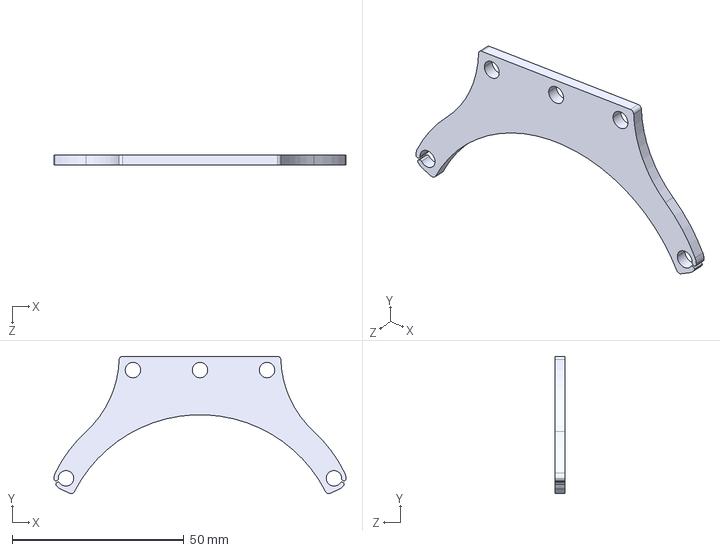
[picture p58: CAD file, 2025-08-22, last stored version]
SolidWorks/STEP_Files/J1_E.STEP
84.9 x 40.0 x 3.00 mm
