hiroyams/openarm_hardware/SolidWorks/STEP_Files/J2_A.STEP

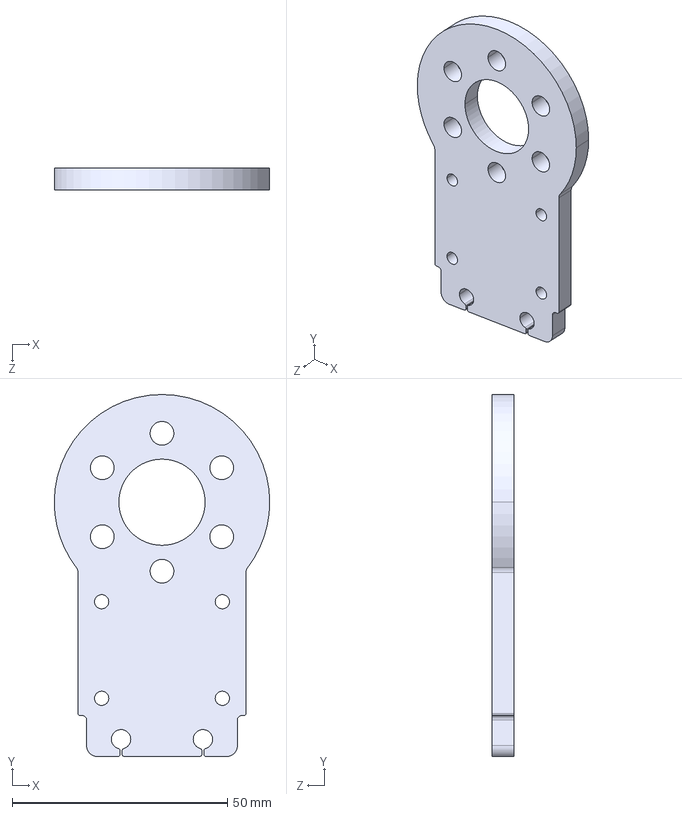
[picture p59: CAD file, 2025-08-22, last stored version]
SolidWorks/STEP_Files/J2_A.STEP
50.0 x 84.0 x 5.00 mm
