hiroyams/openarm_hardware/SolidWorks/STEP_Files/J6_B.STEP

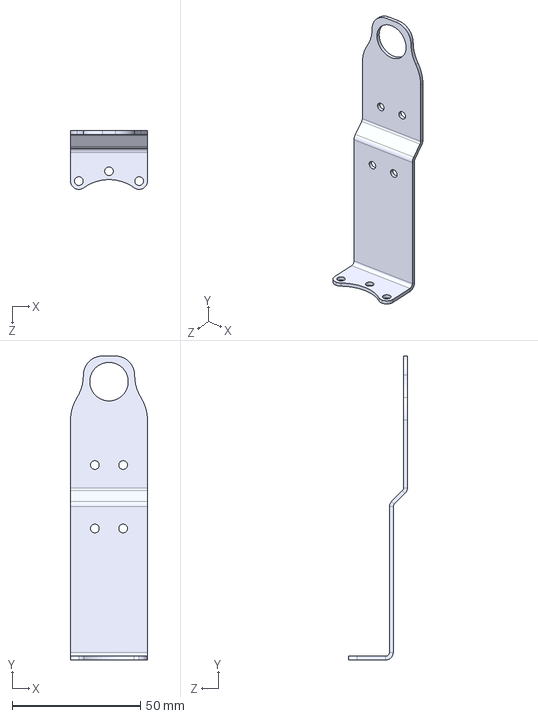
[picture p60: CAD file, 2025-08-22, last stored version]
SolidWorks/STEP_Files/J6_B.STEP
30.0 x 118.5 x 22.9 mm
