hiroyams/openarm_hardware/SolidWorks/STEP_Files/J6_A.STEP

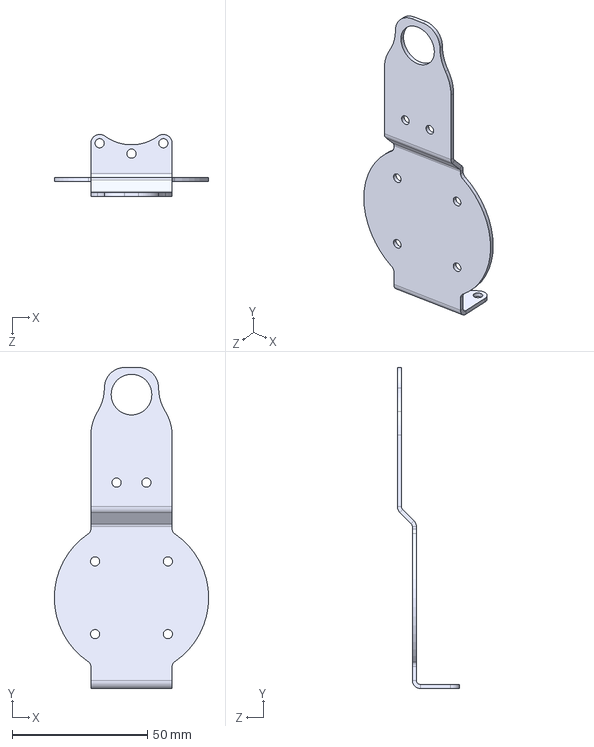
[picture p61: CAD file, 2025-08-22, last stored version]
SolidWorks/STEP_Files/J6_A.STEP
57.0 x 118.5 x 22.9 mm
