hiroyams/openarm_hardware/SolidWorks/assemblies/right_arm/L2_right.SLDASM

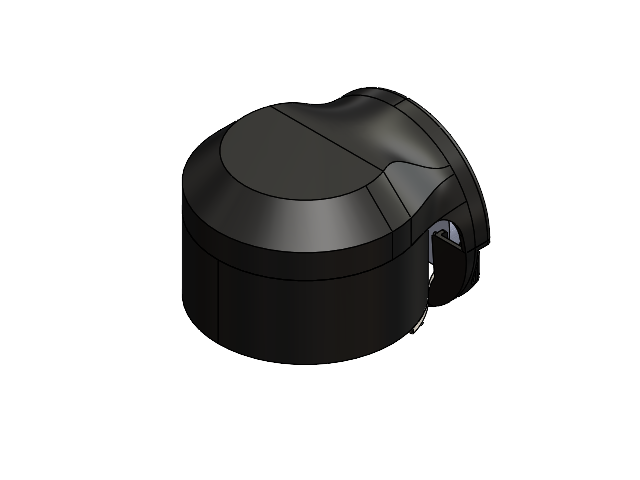
[picture p63: CAD file, 2025-08-22, last stored version]
SolidWorks/assemblies/right_arm/L2_right.SLDASM
DM-J8009P-2EC
J1_C
J1_D
J1_E
CBE5-10 x 6
CBE4-10 x 5
CBE4-8 x 5
J1-J2_Cover
