hiroyams/openarm_hardware/SolidWorks/assemblies/right_arm/L6_right.SLDASM

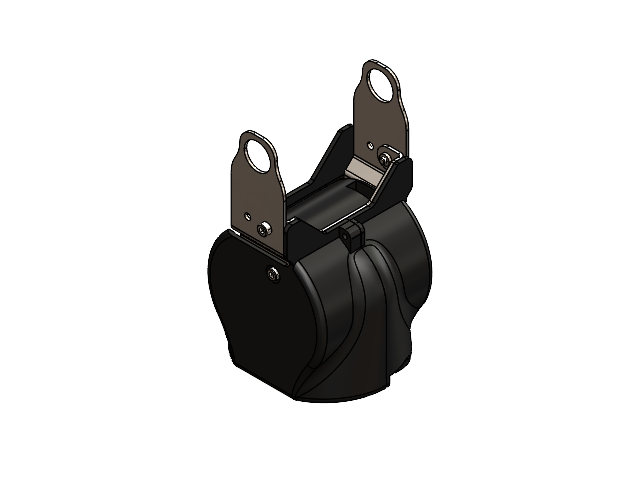
[picture p65: CAD file, 2025-08-22, last stored version]
SolidWorks/assemblies/right_arm/L6_right.SLDASM
DM-J4310-2EC
J5_A
J6_A
J6_B
J6_D
CBE3-8 x 6
CBE3-18 x 6
CBE3-6 x 11
J6_C_right
J6-J7_Cover
