hiroyams/openarm_hardware/SolidWorks/pedestal/pedestal_OpenArm01.SLDASM

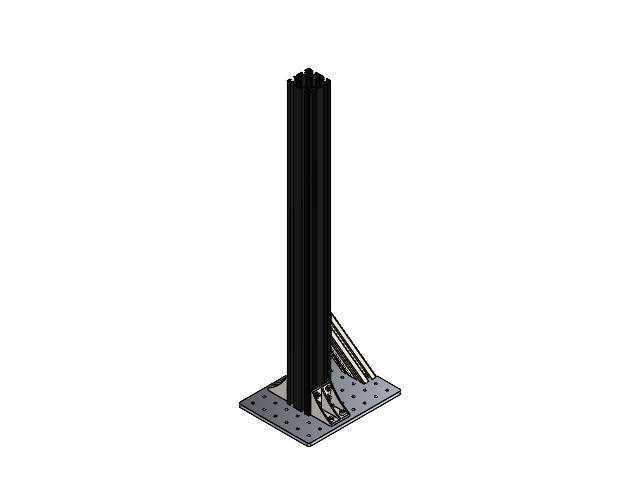
[picture p66: CAD file, 2025-08-22, last stored version]
SolidWorks/pedestal/pedestal_OpenArm01.SLDASM
HBLFSDW6-SEP_b.STEP x 2
CBM6-12.STEP x 16
HNTP6-6_app.STEP x 8
HFBL30A6-3060-123-SSP_b.STEP
SCB6-12.STEP x 4
SPWF6.STEP x 4
SHNTP6-6.STEP x 2
base_plate.STEP
Reazon_HFSB6_6060_750.STEP
