hiroyams/openarm_hardware/SolidWorks/assemblies/left_arm/L6_left.SLDASM

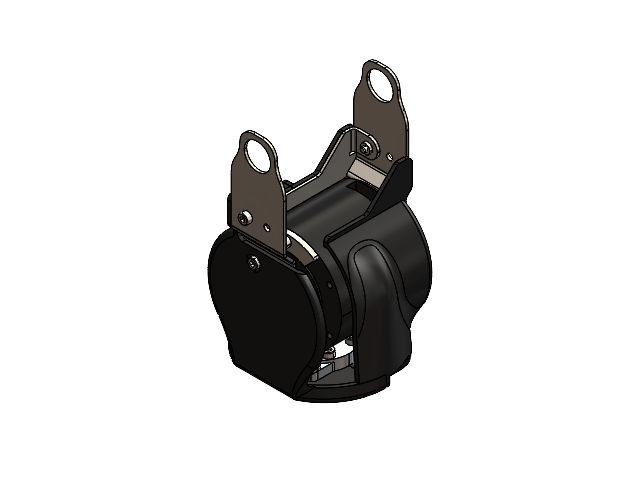
[picture p67: CAD file, 2025-08-22, last stored version]
SolidWorks/assemblies/left_arm/L6_left.SLDASM
DM-J4310-2EC
J5_A
J6_A
J6_B
J6_D
CBE3-8 x 6
CBE3-18 x 6
CBE3-6 x 11
J6_C_left
J6-J7_Cover_Left
