hiroyams/openarm_hardware/SolidWorks/assemblies/right_arm/gripper_right.SLDASM

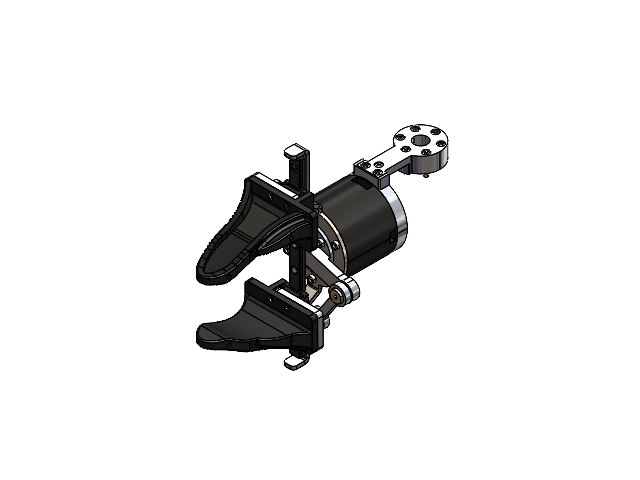
[picture p68: CAD file, 2025-08-22, last stored version]
SolidWorks/assemblies/right_arm/gripper_right.SLDASM
DM-J4310-2EC
rail_connector
J8_B
J8_A
swivel_rotor
swivel_link x 2
mr126zz x 4
rse2b10-155_rail
rseb10_block x 2
rail_CNC_attachment x 2
KBBS3-6 x 16
CBE3-5 x 4
CBE3-8 x 14
DBSY4-5-4 x 4
CBE3-6 x 3
CBE3-15 x 6
right_jaw
left_jaw
