hiroyams/openarm_hardware/SolidWorks/assemblies/left_arm/L5_left.SLDASM

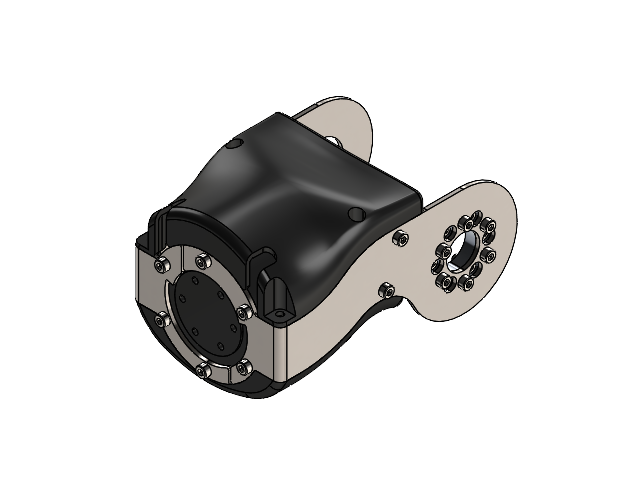
[picture p69: CAD file, 2025-08-22, last stored version]
SolidWorks/assemblies/left_arm/L5_left.SLDASM
DM-J4310-2EC
J4_E
J4_D
J4_C
aetts8-74_2-sc0-m3-n3 x 2
CBE3-6 x 22
J4-J5_Cover
