hiroyams/openarm_hardware/SolidWorks/assemblies/right_arm/L4_right.SLDASM

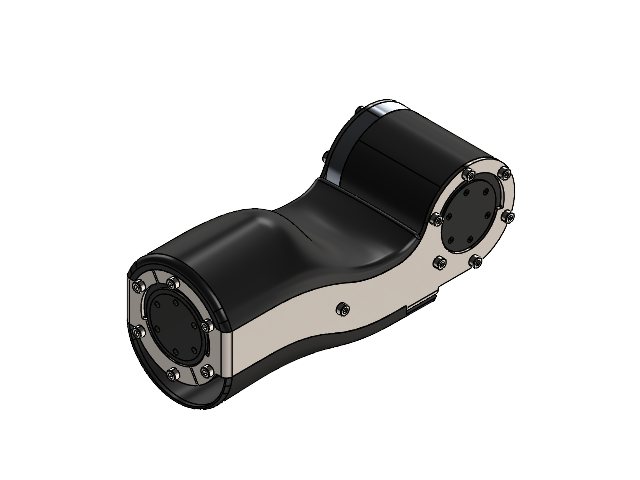
[picture p71: CAD file, 2025-08-22, last stored version]
SolidWorks/assemblies/right_arm/L4_right.SLDASM
DM-J4340P-2EC
J4_A
CBE3-6 x 24
aetts8-61-sc0-m3-n3
DM-J4340-2EC
J4_B
fl6803zz
J3-J4_Cover
