hiroyams/openarm_hardware/SolidWorks/assemblies/left_arm/L3_left.SLDASM

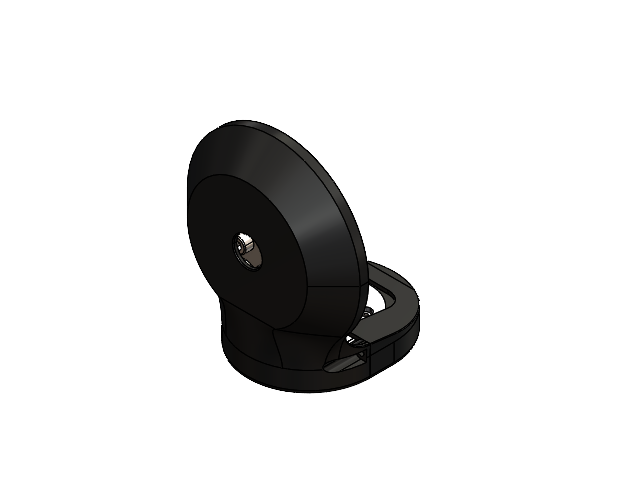
[picture p72: CAD file, 2025-08-22, last stored version]
SolidWorks/assemblies/left_arm/L3_left.SLDASM
J2_A
J2_B
J2_C
CBE5-10 x 6
CBE4-6 x 8
CBE4-10 x 2
J2-J3_Cover
CBE3-15 x 6
