hiroyams/openarm_hardware/SolidWorks/assemblies/right_arm/L7_right.SLDASM

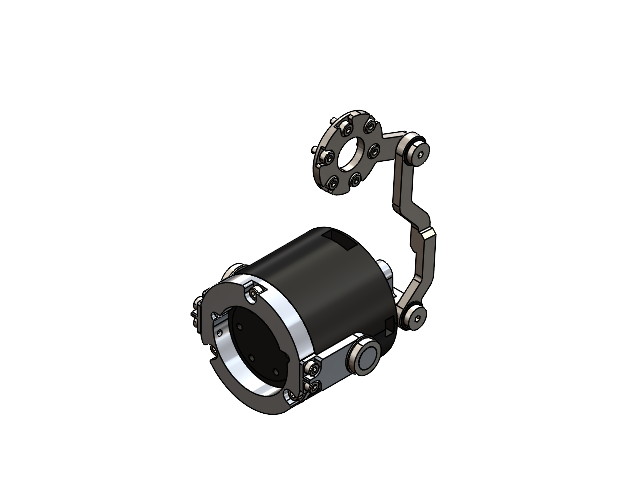
[picture p73: CAD file, 2025-08-22, last stored version]
SolidWorks/assemblies/right_arm/L7_right.SLDASM
DM-J4310-2EC
J7_A
J7_B x 2
J7_C
CBE3-8 x 9
J7_D_right
mr106zz1 x 2
swsps12-6-0.5 x 4
J7_E
CBE3-6 x 6
step_bolt_M4_6_5 x 2
fl6700zz x 2
