hiroyams/openarm_hardware/SolidWorks/assemblies/left_arm/L1_left.SLDASM

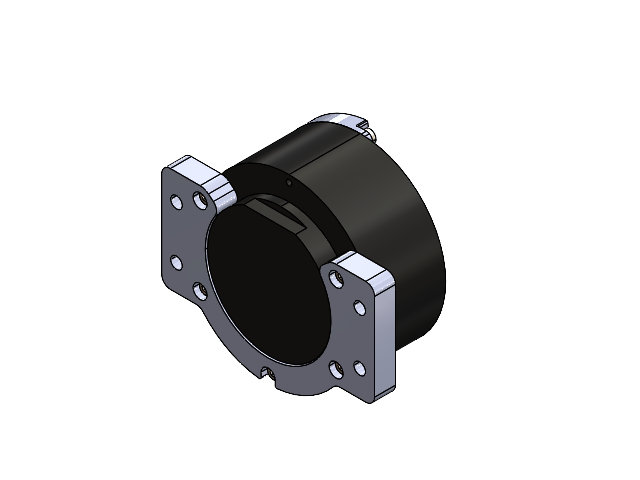
[picture p75: CAD file, 2025-08-22, last stored version]
SolidWorks/assemblies/left_arm/L1_left.SLDASM
J1_A
J1_B
DM-J8009P-2EC
CBE4-10 x 5
CBE4-8 x 3
