hiroyams/openarm_hardware/SolidWorks/assemblies/right_arm/leaderEE_right.SLDASM

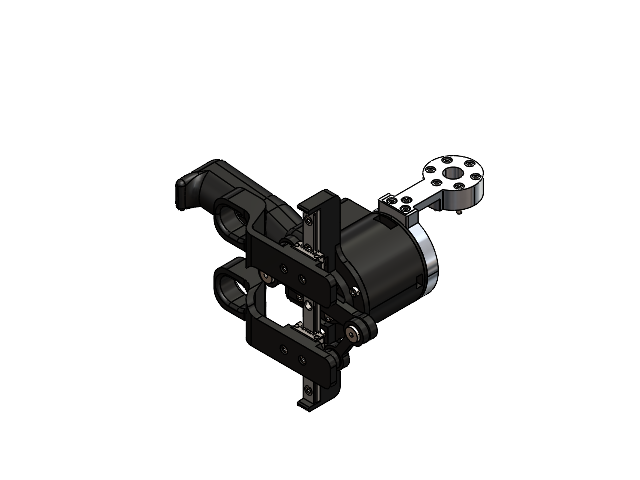
[picture p76: CAD file, 2025-08-22, last stored version]
SolidWorks/assemblies/right_arm/leaderEE_right.SLDASM
DM-J4310-2EC
rail-connector-leader
swivel-rotor-leader
swivel-link-leader x 2
mr126zz x 4
SSE2BZ-MX10-135_rail
SEBSZ-MX10_block x 2
right-pincer
left-pincer
J8_B
J8_A
CBE3-6 x 11
DBSY4-5-4 x 4
CBE3-12 x 4
CBE3-8 x 4
CBE3-15 x 8
CBE3-10 x 4
