hiroyams/openarm_hardware/(list of files, cad)

Other CAD files:
SolidWorks/assemblies/left_arm/L2_left.SLDASM
SolidWorks/assemblies/left_arm/L4_left.SLDASM
SolidWorks/assemblies/right_arm/L3_right.SLDASM
SolidWorks/assemblies/right_arm/L5_right.SLDASM
STL/covers/right/right_covers.3mf
STL/wrist-camera-mount/camera_mount_right.STL
SolidWorks/SLDPRT_Files/wrist_camera_mount_left.SLDPRT
STL/follower/right-jaw.STL
STL/wrist-camera-mount/camera_mount_left.STL
STL/covers/left/j2-b-left.STL
STL/covers/left/j6-a-left.STL
STL/covers/right/j6-b-right.STL
SolidWorks/covers/J6-J7_Cover.SLDPRT
STL/covers/left/j1-a-left.STL
STL/covers/right/j1-b-right.STL
STL/covers/right/j2-a-right.STL
STL/leader/left-pincer.STL
STL/covers/left/j3-a-left.STL
SolidWorks/STEP_Files/swivel-link-leader.STEP
SolidWorks/STEP_Files/J7_D_left.STEP
SolidWorks/STEP_Files/J6_C_right.STEP
SolidWorks/STEP_Files/swivel-rotor-leader.STEP
SolidWorks/STEP_Files/right-pincer.STEP
SolidWorks/STEP_Files/left-pincer.STEP
SolidWorks/STEP_Files/left_jaw.STEP
SolidWorks/STEP_Files/right_jaw.STEP
STL/end-effector-follower/right-jaw.STL
STL/end-effector-leader/left-pincer.STL
STL_Files/covers/left/j1-a-left.STL
STL_Files/covers/left/j1-b-left.STL
STL_Files/covers/left/j2-a-left.STL
STL_Files/covers/left/j2-b-left.STL
STL_Files/covers/left/j3-a-left.STL
STL_Files/covers/left/j6-a-left.STL
STL_Files/covers/left/j6-b-left.STL
STL_Files/covers/right/j1-a-right.STL
STL_Files/covers/right/j1-b-right.STL
STL_Files/covers/right/j2-a-right.STL
STL_Files/covers/right/j2-b-right.STL
STL_Files/covers/right/j6-a-right.STL
STL_Files/covers/right/j6-b-right.STL
STL_Files/end-effector-follower/right-jaw.STL
STL_Files/end-effector-leader/left-pincer.STL
SolidWorks/SLDPRT_Files/J1_A.SLDPRT
SolidWorks/SLDPRT_Files/J1_B.SLDPRT
SolidWorks/SLDPRT_Files/J1_C.SLDPRT
SolidWorks/SLDPRT_Files/J1_D.SLDPRT
SolidWorks/SLDPRT_Files/J1_E.SLDPRT
SolidWorks/SLDPRT_Files/J2_A.SLDPRT
SolidWorks/SLDPRT_Files/J2_B.SLDPRT
SolidWorks/SLDPRT_Files/J2_C.SLDPRT
SolidWorks/SLDPRT_Files/J4_A.SLDPRT
SolidWorks/SLDPRT_Files/J4_B.SLDPRT
SolidWorks/SLDPRT_Files/J4_C.SLDPRT
SolidWorks/SLDPRT_Files/J4_D.SLDPRT
SolidWorks/SLDPRT_Files/J4_E.SLDPRT
SolidWorks/SLDPRT_Files/J5_A.SLDPRT
SolidWorks/SLDPRT_Files/J6_A.SLDPRT
SolidWorks/SLDPRT_Files/J6_B.SLDPRT
SolidWorks/SLDPRT_Files/J6_C_left.SLDPRT
SolidWorks/SLDPRT_Files/J6_C_right.SLDPRT
SolidWorks/SLDPRT_Files/J6_D.SLDPRT
SolidWorks/SLDPRT_Files/J7_A.SLDPRT
SolidWorks/SLDPRT_Files/J7_B.SLDPRT
SolidWorks/SLDPRT_Files/J7_C.SLDPRT
SolidWorks/SLDPRT_Files/J7_D_left.SLDPRT
SolidWorks/SLDPRT_Files/J7_D_right.SLDPRT
SolidWorks/SLDPRT_Files/J7_E.SLDPRT
SolidWorks/SLDPRT_Files/J8_A.SLDPRT
SolidWorks/SLDPRT_Files/J8_B.SLDPRT
SolidWorks/SLDPRT_Files/left-pincer.SLDPRT
SolidWorks/SLDPRT_Files/left_jaw.SLDPRT
SolidWorks/SLDPRT_Files/rail-connector-leader.SLDPRT
SolidWorks/SLDPRT_Files/rail_CNC_attachment.SLDPRT
SolidWorks/SLDPRT_Files/rail_connector.SLDPRT
SolidWorks/SLDPRT_Files/right-pincer.SLDPRT
SolidWorks/SLDPRT_Files/right_jaw.SLDPRT
SolidWorks/SLDPRT_Files/swivel-link-leader.SLDPRT
SolidWorks/SLDPRT_Files/swivel-rotor-leader.SLDPRT
SolidWorks/SLDPRT_Files/swivel_link.SLDPRT
SolidWorks/SLDPRT_Files/swivel_rotor.SLDPRT
SolidWorks/off-the-shelf/CBE3-10.SLDPRT
SolidWorks/off-the-shelf/CBE3-12.SLDPRT
SolidWorks/off-the-shelf/CBE3-15.SLDPRT
SolidWorks/off-the-shelf/CBE3-18.SLDPRT
SolidWorks/off-the-shelf/CBE3-5.SLDPRT
SolidWorks/off-the-shelf/CBE3-6.SLDPRT
SolidWorks/off-the-shelf/CBE3-8.SLDPRT
SolidWorks/off-the-shelf/CBE4-10.SLDPRT
SolidWorks/off-the-shelf/CBE4-6.SLDPRT
SolidWorks/off-the-shelf/CBE4-8.SLDPRT
SolidWorks/off-the-shelf/CBE5-10.SLDPRT
SolidWorks/off-the-shelf/DBSY4-5-4.SLDPRT
SolidWorks/off-the-shelf/KBBS3-6.SLDPRT
SolidWorks/off-the-shelf/SEBSZ-MX10_block.SLDPRT
SolidWorks/off-the-shelf/SSE2BZ-MX10-135_rail.SLDPRT
SolidWorks/off-the-shelf/aetts8-61-sc0-m3-n3.SLDPRT
SolidWorks/off-the-shelf/aetts8-74_2-sc0-m3-n3.SLDPRT
SolidWorks/off-the-shelf/fl6700zz.SLDPRT
SolidWorks/off-the-shelf/fl6803zz.SLDPRT
SolidWorks/off-the-shelf/mr106zz1.SLDPRT
SolidWorks/off-the-shelf/mr126zz.SLDPRT
SolidWorks/off-the-shelf/rse2b10-155_rail.SLDPRT
SolidWorks/off-the-shelf/rseb10_block.SLDPRT
SolidWorks/off-the-shelf/step_bolt_M4_6_5.SLDPRT
SolidWorks/off-the-shelf/swsps12-6-0.5.SLDPRT
