hiroyams/openarm_hardware/(commit log)

2025-07-16 added bimanual assembly step file
2025-07-17 added STL files and leader STEP
    [chest-a.STL, chest-b.STL, ee-linkage.STL, end-effector-leader.step, j1-a-left.STL, j1-a-right.STL, j1-b-left.STL, j1-b-right.STL]
2025-07-18 changed folder name
    [chest-a.STL, chest-b.STL, ee-linkage.STL, j1-a-left.STL, j1-a-right.STL, j1-b-left.STL, j1-b-right.STL, j2-a-left.STL]
2025-07-18 changed file structure
    [ee-linkage.STL, end-effector-leader.step, left-jaw.STL, left-pincer.STL, rail-connector-leader.STL, right-jaw.STL, right-pincer.STL, rotor-controller-leader.STL]
2025-07-22 updated CAD
    [swivel-link-leader.STL, swivel-rotor-leader.STL]
2025-07-22 added STL
    [j1-a-left.STL, j1-a-right.STL, j1-b-left.STL, j1-b-right.STL, j2-a-left.STL, j2-a-right.STL, j2-b-left.STL, j2-b-right.STL]
2025-07-23 added electrical components
    [BOM_For_Hub.csv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]
2025-08-22 added SolidWorks files
    [CBE3-10.SLDPRT, CBE3-12.SLDPRT, CBE3-15.SLDPRT, CBE3-18.SLDPRT, CBE3-5.SLDPRT, CBE3-6.SLDPRT, CBE3-8.SLDPRT, CBE4-10.SLDPRT]
2025-08-22 modified assembly files
    [pedestal_OpenArm01.SLDASM, pedestal_v1.0_final.STEP]
2025-08-27 added 3mf files
    [left_covers.3mf, right_covers.3mf]
2025-09-16 added wrist camera mounts
    [camera_mount_left.STL, camera_mount_right.STL, wrist_camera_mount_left.SLDPRT, wrist_camera_mount_right.SLDPRT]
2025-10-31 Revise README
    Updated the README to enhance clarity and organization of CAD files and contribution guidelines.
